ydss0857/stream-conv-engine-rtl-to-gds/asic/results/hs_w128_80mhz/metrics.csv

Metric | Value
design__lint_error__count | 0
design__lint_timing_construct__count | 0
design__lint_warning__count | 413
design__inferred_latch__count | 0
design__instance__count | 62236
design__instance__area | 561398
design__instance_unmapped__count | 0
synthesis__check_error__count | 0
design__max_slew_violation__count__corner:nom_tt_025C_1v80 | 77
design__max_fanout_violation__count__corner:nom_tt_025C_1v80 | 10
design__max_cap_violation__count__corner:nom_tt_025C_1v80 | 4
power__internal__total | 0.02661510743200779
power__switching__total | 0.009540827013552189
power__leakage__total | 0.02655705064535141
power__total | 0.06271298229694366
clock__skew__worst_hold__corner:nom_tt_025C_1v80 | -0.48575744801463805
clock__skew__worst_setup__corner:nom_tt_025C_1v80 | 0.35766704499367674
timing__hold__ws__corner:nom_tt_025C_1v80 | 0.28551906092004853
timing__setup__ws__corner:nom_tt_025C_1v80 | 4.691795529331594
timing__hold__tns__corner:nom_tt_025C_1v80 | 0.0
timing__setup__tns__corner:nom_tt_025C_1v80 | 0.0
timing__hold__wns__corner:nom_tt_025C_1v80 | 0
timing__setup__wns__corner:nom_tt_025C_1v80 | 0.0
timing__hold_vio__count__corner:nom_tt_025C_1v80 | 0
timing__hold_r2r__ws__corner:nom_tt_025C_1v80 | 0.285519
timing__hold_r2r_vio__count__corner:nom_tt_025C_1v80 | 0
timing__setup_vio__count__corner:nom_tt_025C_1v80 | 0
timing__setup_r2r__ws__corner:nom_tt_025C_1v80 | 4.691795
timing__setup_r2r_vio__count__corner:nom_tt_025C_1v80 | 0
design__max_slew_violation__count__corner:nom_ss_100C_1v60 | 2962
design__max_fanout_violation__count__corner:nom_ss_100C_1v60 | 10
design__max_cap_violation__count__corner:nom_ss_100C_1v60 | 50
clock__skew__worst_hold__corner:nom_ss_100C_1v60 | -0.6415667068086316
clock__skew__worst_setup__corner:nom_ss_100C_1v60 | 0.4199943567362062
timing__hold__ws__corner:nom_ss_100C_1v60 | 0.6066265439455707
timing__setup__ws__corner:nom_ss_100C_1v60 | -0.745168392526911
timing__hold__tns__corner:nom_ss_100C_1v60 | 0.0
timing__setup__tns__corner:nom_ss_100C_1v60 | -5.656434591930299
timing__hold__wns__corner:nom_ss_100C_1v60 | 0
timing__setup__wns__corner:nom_ss_100C_1v60 | -0.745168392526911
timing__hold_vio__count__corner:nom_ss_100C_1v60 | 0
timing__hold_r2r__ws__corner:nom_ss_100C_1v60 | 0.606627
timing__hold_r2r_vio__count__corner:nom_ss_100C_1v60 | 0
timing__setup_vio__count__corner:nom_ss_100C_1v60 | 9
timing__setup_r2r__ws__corner:nom_ss_100C_1v60 | -0.745168
timing__setup_r2r_vio__count__corner:nom_ss_100C_1v60 | 9
design__max_slew_violation__count__corner:nom_ff_n40C_1v95 | 0
design__max_fanout_violation__count__corner:nom_ff_n40C_1v95 | 10
design__max_cap_violation__count__corner:nom_ff_n40C_1v95 | 4
clock__skew__worst_hold__corner:nom_ff_n40C_1v95 | -0.4119007196354827
clock__skew__worst_setup__corner:nom_ff_n40C_1v95 | 0.32648792926635684
timing__hold__ws__corner:nom_ff_n40C_1v95 | 0.10603929146008653
timing__setup__ws__corner:nom_ff_n40C_1v95 | 6.915474166830332
timing__hold__tns__corner:nom_ff_n40C_1v95 | 0.0
timing__setup__tns__corner:nom_ff_n40C_1v95 | 0.0
timing__hold__wns__corner:nom_ff_n40C_1v95 | 0
timing__setup__wns__corner:nom_ff_n40C_1v95 | 0.0
timing__hold_vio__count__corner:nom_ff_n40C_1v95 | 0
timing__hold_r2r__ws__corner:nom_ff_n40C_1v95 | 0.106039
timing__hold_r2r_vio__count__corner:nom_ff_n40C_1v95 | 0
timing__setup_vio__count__corner:nom_ff_n40C_1v95 | 0
timing__setup_r2r__ws__corner:nom_ff_n40C_1v95 | 7.211676
timing__setup_r2r_vio__count__corner:nom_ff_n40C_1v95 | 0
design__max_slew_violation__count | 3602
design__max_fanout_violation__count | 10
design__max_cap_violation__count | 92
clock__skew__worst_hold | -0.4022102487132792
clock__skew__worst_setup | 0.31881898024013905
timing__hold__ws | 0.10480927533631709
timing__setup__ws | -1.075221719870961
timing__hold__tns | 0.0
timing__setup__tns | -9.52268069130037
timing__hold__wns | 0
timing__setup__wns | -1.075221719870961
timing__hold_vio__count | 0
timing__hold_r2r__ws | 0.104809
timing__hold_r2r_vio__count | 0
timing__setup_vio__count | 34
timing__setup_r2r__ws | -1.075222
timing__setup_r2r_vio__count | 34
design__die__bbox | 0.0 0.0 761.25 776.37
design__core__bbox | 5.76 13.32 755.04 762.57
design__io | 154
design__die__area | 591012
design__core__area | 561398
design__instance__count__stdcell | 30244
design__instance__area__stdcell | 378300
design__instance__count__macros | 0
design__instance__area__macros | 0
design__instance__count__padcells | 0
design__instance__area__padcells | 0
design__instance__count__cover | 0
design__instance__area__cover | 0
design__instance__utilization | 0.673853
design__instance__utilization__stdcell | 0.673853
design__rows | 225
design__rows:unit | 225
design__sites | 351225
design__sites:unit | 351225
design__instance__count__class:buffer | 18
design__instance__area__class:buffer | 143.856
design__instance__count__class:inverter | 141
design__instance__area__class:inverter | 676.123
design__instance__count__class:sequential_cell | 3931
design__instance__area__class:sequential_cell | 113100
design__instance__count__class:multi_input_combinational_cell | 12960
design__instance__area__class:multi_input_combinational_cell | 167191
flow__warnings__count | 1
flow__errors__count | 0
flow__warnings__count:ODB-0220 | 1
flow__warnings__type_count | 1
flow__warnings__count:ORD-0039 | 1
flow__warnings__count:STA-0122 | 43
design__instance__count__class:fill_cell | 31992
design__instance__area__class:fill_cell | 183098
design__instance__count__class:tap_cell | 6469
design__instance__area__class:tap_cell | 10340
design__power_grid_violation__count__net:VGND | 0
design__power_grid_violation__count__net:VPWR | 0
design__power_grid_violation__count | 0
floorplan__design__io | 152
design__io__hpwl | 28342615
flow__warnings__count:GRT-0281 | 1
timing__drv__floating__nets | 2
timing__drv__floating__pins | 0
design__instance__displacement__total | 38707.8
design__instance__displacement__mean | 1.264
design__instance__displacement__max | 34.68
route__wirelength__estimated | 713061
design__violations | 0
design__instance__count__class:timing_repair_buffer | 5784
design__instance__area__class:timing_repair_buffer | 73857.3
flow__warnings__count:RSZ-0020 | 1
flow__warnings__count:STA-1140 | 6
design__instance__count__class:clock_buffer | 581
design__instance__area__class:clock_buffer | 10229.8
design__instance__count__class:clock_inverter | 283
design__instance__area__class:clock_inverter | 2515.88
design__instance__count__setup_buffer | 0
design__instance__count__hold_buffer | 4091
global_route__vias | 36
global_route__wirelength | 1157011
antenna__violating__nets | 0
antenna__violating__pins | 0
route__antenna_violation__count | 0
antenna_diodes_count | 55
design__instance__count__class:antenna_cell | 77
design__instance__area__class:antenna_cell | 246.154
route__net | 23439
route__net__special | 2
route__drc_errors__iter:0 | 30
route__wirelength__iter:0 | 804485
route__drc_errors__iter:1 | 5
route__wirelength__iter:1 | 804474
route__drc_errors__iter:2 | 4
route__wirelength__iter:2 | 804474
route__drc_errors__iter:3 | 0
route__wirelength__iter:3 | 804469
route__drc_errors__iter:4 | 0
route__wirelength__iter:4 | 804434
route__drc_errors | 0
route__wirelength | 804469
route__vias | 157417
route__vias__singlecut | 157417
route__vias__multicut | 0
flow__warnings__count:DRT-0349 | 10
design__disconnected_pin__count | 22
design__critical_disconnected_pin__count | 0
route__wirelength__max | 1061.38
timing__unannotated_net__count__corner:nom_tt_025C_1v80 | 364
timing__unannotated_net_filtered__count__corner:nom_tt_025C_1v80 | 0
timing__unannotated_net__count__corner:nom_ss_100C_1v60 | 364
timing__unannotated_net_filtered__count__corner:nom_ss_100C_1v60 | 0
timing__unannotated_net__count__corner:nom_ff_n40C_1v95 | 364
timing__unannotated_net_filtered__count__corner:nom_ff_n40C_1v95 | 0
design__max_slew_violation__count__corner:min_tt_025C_1v80 | 22
design__max_fanout_violation__count__corner:min_tt_025C_1v80 | 10
design__max_cap_violation__count__corner:min_tt_025C_1v80 | 4
clock__skew__worst_hold__corner:min_tt_025C_1v80 | -0.47229776981723176
clock__skew__worst_setup__corner:min_tt_025C_1v80 | 0.34747047889138455
timing__hold__ws__corner:min_tt_025C_1v80 | 0.28394032373438177
timing__setup__ws__corner:min_tt_025C_1v80 | 4.851912786649879
timing__hold__tns__corner:min_tt_025C_1v80 | 0.0
timing__setup__tns__corner:min_tt_025C_1v80 | 0.0
timing__hold__wns__corner:min_tt_025C_1v80 | 0
timing__setup__wns__corner:min_tt_025C_1v80 | 0.0
timing__hold_vio__count__corner:min_tt_025C_1v80 | 0
timing__hold_r2r__ws__corner:min_tt_025C_1v80 | 0.283940
timing__hold_r2r_vio__count__corner:min_tt_025C_1v80 | 0
timing__setup_vio__count__corner:min_tt_025C_1v80 | 0
timing__setup_r2r__ws__corner:min_tt_025C_1v80 | 4.851913
timing__setup_r2r_vio__count__corner:min_tt_025C_1v80 | 0
timing__unannotated_net__count__corner:min_tt_025C_1v80 | 364
timing__unannotated_net_filtered__count__corner:min_tt_025C_1v80 | 0
design__max_slew_violation__count__corner:min_ss_100C_1v60 | 2428
design__max_fanout_violation__count__corner:min_ss_100C_1v60 | 10
design__max_cap_violation__count__corner:min_ss_100C_1v60 | 26
clock__skew__worst_hold__corner:min_ss_100C_1v60 | -0.6200894417898395
clock__skew__worst_setup__corner:min_ss_100C_1v60 | 0.4062113260737328
timing__hold__ws__corner:min_ss_100C_1v60 | 0.604035727422032
timing__setup__ws__corner:min_ss_100C_1v60 | -0.4419655877482001
timing__hold__tns__corner:min_ss_100C_1v60 | 0.0
timing__setup__tns__corner:min_ss_100C_1v60 | -3.0907961509454824
timing__hold__wns__corner:min_ss_100C_1v60 | 0
timing__setup__wns__corner:min_ss_100C_1v60 | -0.4419655877482001
timing__hold_vio__count__corner:min_ss_100C_1v60 | 0
timing__hold_r2r__ws__corner:min_ss_100C_1v60 | 0.604036
timing__hold_r2r_vio__count__corner:min_ss_100C_1v60 | 0
timing__setup_vio__count__corner:min_ss_100C_1v60 | 8
timing__setup_r2r__ws__corner:min_ss_100C_1v60 | -0.441966
timing__setup_r2r_vio__count__corner:min_ss_100C_1v60 | 8
timing__unannotated_net__count__corner:min_ss_100C_1v60 | 364
timing__unannotated_net_filtered__count__corner:min_ss_100C_1v60 | 0
design__max_slew_violation__count__corner:min_ff_n40C_1v95 | 0
design__max_fanout_violation__count__corner:min_ff_n40C_1v95 | 10
design__max_cap_violation__count__corner:min_ff_n40C_1v95 | 4
clock__skew__worst_hold__corner:min_ff_n40C_1v95 | -0.4022102487132792
clock__skew__worst_setup__corner:min_ff_n40C_1v95 | 0.31881898024013905
timing__hold__ws__corner:min_ff_n40C_1v95 | 0.10480927533631709
timing__setup__ws__corner:min_ff_n40C_1v95 | 6.949636618442648
timing__hold__tns__corner:min_ff_n40C_1v95 | 0.0
timing__setup__tns__corner:min_ff_n40C_1v95 | 0.0
timing__hold__wns__corner:min_ff_n40C_1v95 | 0
timing__setup__wns__corner:min_ff_n40C_1v95 | 0.0
timing__hold_vio__count__corner:min_ff_n40C_1v95 | 0
timing__hold_r2r__ws__corner:min_ff_n40C_1v95 | 0.104809
timing__hold_r2r_vio__count__corner:min_ff_n40C_1v95 | 0
timing__setup_vio__count__corner:min_ff_n40C_1v95 | 0
timing__setup_r2r__ws__corner:min_ff_n40C_1v95 | 7.313951
timing__setup_r2r_vio__count__corner:min_ff_n40C_1v95 | 0
timing__unannotated_net__count__corner:min_ff_n40C_1v95 | 364
timing__unannotated_net_filtered__count__corner:min_ff_n40C_1v95 | 0
design__max_slew_violation__count__corner:max_tt_025C_1v80 | 173
design__max_fanout_violation__count__corner:max_tt_025C_1v80 | 10
design__max_cap_violation__count__corner:max_tt_025C_1v80 | 4
clock__skew__worst_hold__corner:max_tt_025C_1v80 | -0.5042334470460795
clock__skew__worst_setup__corner:max_tt_025C_1v80 | 0.3778606701150935
timing__hold__ws__corner:max_tt_025C_1v80 | 0.2881622799718314
timing__setup__ws__corner:max_tt_025C_1v80 | 4.522387925480496
timing__hold__tns__corner:max_tt_025C_1v80 | 0.0
timing__setup__tns__corner:max_tt_025C_1v80 | 0.0
timing__hold__wns__corner:max_tt_025C_1v80 | 0
timing__setup__wns__corner:max_tt_025C_1v80 | 0.0
timing__hold_vio__count__corner:max_tt_025C_1v80 | 0
timing__hold_r2r__ws__corner:max_tt_025C_1v80 | 0.288162
timing__hold_r2r_vio__count__corner:max_tt_025C_1v80 | 0
timing__setup_vio__count__corner:max_tt_025C_1v80 | 0
timing__setup_r2r__ws__corner:max_tt_025C_1v80 | 4.522388
timing__setup_r2r_vio__count__corner:max_tt_025C_1v80 | 0
timing__unannotated_net__count__corner:max_tt_025C_1v80 | 364
timing__unannotated_net_filtered__count__corner:max_tt_025C_1v80 | 0
design__max_slew_violation__count__corner:max_ss_100C_1v60 | 3602
design__max_fanout_violation__count__corner:max_ss_100C_1v60 | 10
design__max_cap_violation__count__corner:max_ss_100C_1v60 | 92
clock__skew__worst_hold__corner:max_ss_100C_1v60 | -0.6702978362085705
clock__skew__worst_setup__corner:max_ss_100C_1v60 | 0.44692459331696793
timing__hold__ws__corner:max_ss_100C_1v60 | 0.6107459155726436
timing__setup__ws__corner:max_ss_100C_1v60 | -1.075221719870961
timing__hold__tns__corner:max_ss_100C_1v60 | 0.0
timing__setup__tns__corner:max_ss_100C_1v60 | -9.52268069130037
timing__hold__wns__corner:max_ss_100C_1v60 | 0
timing__setup__wns__corner:max_ss_100C_1v60 | -1.075221719870961
timing__hold_vio__count__corner:max_ss_100C_1v60 | 0
timing__hold_r2r__ws__corner:max_ss_100C_1v60 | 0.610746
timing__hold_r2r_vio__count__corner:max_ss_100C_1v60 | 0
timing__setup_vio__count__corner:max_ss_100C_1v60 | 17
timing__setup_r2r__ws__corner:max_ss_100C_1v60 | -1.075222
timing__setup_r2r_vio__count__corner:max_ss_100C_1v60 | 17
timing__unannotated_net__count__corner:max_ss_100C_1v60 | 364
timing__unannotated_net_filtered__count__corner:max_ss_100C_1v60 | 0
design__max_slew_violation__count__corner:max_ff_n40C_1v95 | 0
design__max_fanout_violation__count__corner:max_ff_n40C_1v95 | 10
design__max_cap_violation__count__corner:max_ff_n40C_1v95 | 4
clock__skew__worst_hold__corner:max_ff_n40C_1v95 | -0.42586338438842086
clock__skew__worst_setup__corner:max_ff_n40C_1v95 | 0.3428012415402391
timing__hold__ws__corner:max_ff_n40C_1v95 | 0.10804257794237698
timing__setup__ws__corner:max_ff_n40C_1v95 | 6.879383923903536
timing__hold__tns__corner:max_ff_n40C_1v95 | 0.0
timing__setup__tns__corner:max_ff_n40C_1v95 | 0.0
timing__hold__wns__corner:max_ff_n40C_1v95 | 0
timing__setup__wns__corner:max_ff_n40C_1v95 | 0.0
timing__hold_vio__count__corner:max_ff_n40C_1v95 | 0
timing__hold_r2r__ws__corner:max_ff_n40C_1v95 | 0.108043
timing__hold_r2r_vio__count__corner:max_ff_n40C_1v95 | 0
timing__setup_vio__count__corner:max_ff_n40C_1v95 | 0
timing__setup_r2r__ws__corner:max_ff_n40C_1v95 | 7.108401
timing__setup_r2r_vio__count__corner:max_ff_n40C_1v95 | 0
timing__unannotated_net__count__corner:max_ff_n40C_1v95 | 364
timing__unannotated_net_filtered__count__corner:max_ff_n40C_1v95 | 0
timing__unannotated_net__count | 364
timing__unannotated_net_filtered__count | 0
design_powergrid__voltage__worst__net:VPWR__corner:nom_ss_100C_1v60 | 1.79825
design_powergrid__drop__average__net:VPWR__corner:nom_ss_100C_1v60 | 1.79973
design_powergrid__drop__worst__net:VPWR__corner:nom_ss_100C_1v60 | 0.00175351
design_powergrid__voltage__worst__net:VGND__corner:nom_ss_100C_1v60 | 0.00170482
design_powergrid__drop__average__net:VGND__corner:nom_ss_100C_1v60 | 0.000268349
design_powergrid__drop__worst__net:VGND__corner:nom_ss_100C_1v60 | 0.00170482
design_powergrid__voltage__worst | 0.00170482
design_powergrid__voltage__worst__net:VPWR | 1.79825
design_powergrid__drop__worst | 0.00175351
design_powergrid__drop__worst__net:VPWR | 0.00175351
design_powergrid__voltage__worst__net:VGND | 0.00170482
design_powergrid__drop__worst__net:VGND | 0.00170482
ir__voltage__worst | 1.8000000000000000444089209850062616169452667236328125
ir__drop__avg | 0.00027300000000000002216282712907968743820674717426300048828125
ir__drop__worst | 0.00175000000000000003642919299551294898265041410923004150390625
design__xor_difference__count | 0
magic__drc_error__count | 0
klayout__drc_error__count | 0
magic__illegal_overlap__count | 0
design__lvs_device_difference__count | 0
design__lvs_net_difference__count | 0
design__lvs_property_fail__count | 0
design__lvs_error__count | 0
design__lvs_unmatched_device__count | 0
design__lvs_unmatched_net__count | 0
design__lvs_unmatched_pin__count | 0
