ydss0857/stream-conv-engine-rtl-to-gds/asic/results/w128_100mhz_v1/metrics.csv

Metric | Value
design__lint_error__count | 0
design__lint_timing_construct__count | 0
design__lint_warning__count | 468
design__inferred_latch__count | 0
design__instance__count | 106407
design__instance__area | 543198
design__instance_unmapped__count | 0
synthesis__check_error__count | 0
design__max_slew_violation__count__corner:nom_tt_025C_1v80 | 922
design__max_fanout_violation__count__corner:nom_tt_025C_1v80 | 104
design__max_cap_violation__count__corner:nom_tt_025C_1v80 | 4
power__internal__total | 0.023907823488116264
power__switching__total | 0.008693979121744633
power__leakage__total | 5.895935828448273E-7
power__total | 0.03260239213705063
clock__skew__worst_hold__corner:nom_tt_025C_1v80 | -0.5646651084316001
clock__skew__worst_setup__corner:nom_tt_025C_1v80 | 0.4305913247836536
timing__hold__ws__corner:nom_tt_025C_1v80 | 0.28795899813027337
timing__setup__ws__corner:nom_tt_025C_1v80 | 2.553215489077126
timing__hold__tns__corner:nom_tt_025C_1v80 | 0.0
timing__setup__tns__corner:nom_tt_025C_1v80 | 0.0
timing__hold__wns__corner:nom_tt_025C_1v80 | 0
timing__setup__wns__corner:nom_tt_025C_1v80 | 0.0
timing__hold_vio__count__corner:nom_tt_025C_1v80 | 0
timing__hold_r2r__ws__corner:nom_tt_025C_1v80 | 0.287959
timing__hold_r2r_vio__count__corner:nom_tt_025C_1v80 | 0
timing__setup_vio__count__corner:nom_tt_025C_1v80 | 0
timing__setup_r2r__ws__corner:nom_tt_025C_1v80 | 3.291264
timing__setup_r2r_vio__count__corner:nom_tt_025C_1v80 | 0
design__max_slew_violation__count__corner:nom_ss_100C_1v60 | 5017
design__max_fanout_violation__count__corner:nom_ss_100C_1v60 | 104
design__max_cap_violation__count__corner:nom_ss_100C_1v60 | 21
clock__skew__worst_hold__corner:nom_ss_100C_1v60 | -0.7956744377469622
clock__skew__worst_setup__corner:nom_ss_100C_1v60 | 0.5654447070615405
timing__hold__ws__corner:nom_ss_100C_1v60 | -0.28622927060898734
timing__setup__ws__corner:nom_ss_100C_1v60 | -2.5973179897546395
timing__hold__tns__corner:nom_ss_100C_1v60 | -7.600564837081983
timing__setup__tns__corner:nom_ss_100C_1v60 | -3054.2201738853555
timing__hold__wns__corner:nom_ss_100C_1v60 | -0.28622927060898734
timing__setup__wns__corner:nom_ss_100C_1v60 | -2.5973179897546395
timing__hold_vio__count__corner:nom_ss_100C_1v60 | 47
timing__hold_r2r__ws__corner:nom_ss_100C_1v60 | 0.835629
timing__hold_r2r_vio__count__corner:nom_ss_100C_1v60 | 0
timing__setup_vio__count__corner:nom_ss_100C_1v60 | 2518
timing__setup_r2r__ws__corner:nom_ss_100C_1v60 | -2.597318
timing__setup_r2r_vio__count__corner:nom_ss_100C_1v60 | 2481
design__max_slew_violation__count__corner:nom_ff_n40C_1v95 | 96
design__max_fanout_violation__count__corner:nom_ff_n40C_1v95 | 104
design__max_cap_violation__count__corner:nom_ff_n40C_1v95 | 4
clock__skew__worst_hold__corner:nom_ff_n40C_1v95 | -0.46967298046817885
clock__skew__worst_setup__corner:nom_ff_n40C_1v95 | 0.37583359710382774
timing__hold__ws__corner:nom_ff_n40C_1v95 | 0.09106782252729179
timing__setup__ws__corner:nom_ff_n40C_1v95 | 4.532833348080796
timing__hold__tns__corner:nom_ff_n40C_1v95 | 0.0
timing__setup__tns__corner:nom_ff_n40C_1v95 | 0.0
timing__hold__wns__corner:nom_ff_n40C_1v95 | 0
timing__setup__wns__corner:nom_ff_n40C_1v95 | 0.0
timing__hold_vio__count__corner:nom_ff_n40C_1v95 | 0
timing__hold_r2r__ws__corner:nom_ff_n40C_1v95 | 0.091068
timing__hold_r2r_vio__count__corner:nom_ff_n40C_1v95 | 0
timing__setup_vio__count__corner:nom_ff_n40C_1v95 | 0
timing__setup_r2r__ws__corner:nom_ff_n40C_1v95 | 5.547333
timing__setup_r2r_vio__count__corner:nom_ff_n40C_1v95 | 0
design__max_slew_violation__count | 5888
design__max_fanout_violation__count | 104
design__max_cap_violation__count | 33
clock__skew__worst_hold | -0.4553037797877009
clock__skew__worst_setup | 0.36692461219075984
timing__hold__ws | -0.4442042415183677
timing__setup__ws | -3.036861514883817
timing__hold__tns | -16.775530772663068
timing__setup__tns | -3873.726764557994
timing__hold__wns | -0.4442042415183677
timing__setup__wns | -3.036861514883817
timing__hold_vio__count | 158
timing__hold_r2r__ws | 0.091068
timing__hold_r2r_vio__count | 0
timing__setup_vio__count | 7537
timing__setup_r2r__ws | -3.036861
timing__setup_r2r_vio__count | 7428
design__die__bbox | 0.0 0.0 748.38 759.1
design__core__bbox | 5.52 10.88 742.44 748.0
design__io | 154
design__die__area | 568095
design__core__area | 543198
design__instance__count__stdcell | 31687
design__instance__area__stdcell | 290836
design__instance__count__macros | 0
design__instance__area__macros | 0
design__instance__count__padcells | 0
design__instance__area__padcells | 0
design__instance__count__cover | 0
design__instance__area__cover | 0
design__instance__utilization | 0.535415
design__instance__utilization__stdcell | 0.535415
design__rows | 271
design__rows:unithd | 271
design__sites | 434142
design__sites:unithd | 434142
design__instance__count__class:buffer | 18
design__instance__area__class:buffer | 90.0864
design__instance__count__class:inverter | 227
design__instance__area__class:inverter | 869.584
design__instance__count__class:sequential_cell | 3573
design__instance__area__class:sequential_cell | 76074.2
design__instance__count__class:multi_input_combinational_cell | 13781
design__instance__area__class:multi_input_combinational_cell | 141492
flow__warnings__count | 1
flow__errors__count | 0
flow__warnings__count:ODB-0220 | 2
flow__warnings__type_count | 1
flow__warnings__count:ORD-0039 | 1
design__instance__count__class:fill_cell | 74720
design__instance__area__class:fill_cell | 252362
design__instance__count__class:tap_cell | 7780
design__instance__area__class:tap_cell | 9734.34
design__power_grid_violation__count__net:VGND | 0
design__power_grid_violation__count__net:VPWR | 0
design__power_grid_violation__count | 0
floorplan__design__io | 152
design__io__hpwl | 29567017
flow__warnings__count:GRT-0281 | 1
timing__drv__floating__nets | 2
timing__drv__floating__pins | 0
design__instance__displacement__total | 17320.5
design__instance__displacement__mean | 0.538
design__instance__displacement__max | 30.164
route__wirelength__estimated | 682442
design__violations | 0
design__instance__count__class:timing_repair_buffer | 5621
design__instance__area__class:timing_repair_buffer | 54410.9
flow__warnings__count:RSZ-0020 | 1
flow__warnings__count:STA-1140 | 6
design__instance__count__class:clock_buffer | 543
design__instance__area__class:clock_buffer | 7297
design__instance__count__class:clock_inverter | 52
design__instance__area__class:clock_inverter | 638.112
design__instance__count__setup_buffer | 30
design__instance__count__hold_buffer | 566
flow__warnings__count:RSZ-0062 | 1
global_route__vias | 97
global_route__wirelength | 1106856
antenna__violating__nets | 0
antenna__violating__pins | 0
route__antenna_violation__count | 0
antenna_diodes_count | 42
design__instance__count__class:antenna_cell | 92
design__instance__area__class:antenna_cell | 230.221
route__net | 23746
route__net__special | 2
route__drc_errors__iter:0 | 36
route__wirelength__iter:0 | 772403
route__drc_errors__iter:1 | 5
route__wirelength__iter:1 | 772383
route__drc_errors__iter:2 | 5
route__wirelength__iter:2 | 772382
route__drc_errors__iter:3 | 0
route__wirelength__iter:3 | 772371
route__drc_errors__iter:4 | 1
route__wirelength__iter:4 | 772496
route__drc_errors__iter:5 | 0
route__wirelength__iter:5 | 772486
route__drc_errors | 0
route__wirelength | 772371
route__vias | 164251
route__vias__singlecut | 164251
route__vias__multicut | 0
flow__warnings__count:DRT-0349 | 10
design__disconnected_pin__count | 13
design__critical_disconnected_pin__count | 0
route__wirelength__max | 1125.89
timing__unannotated_net__count__corner:nom_tt_025C_1v80 | 174
timing__unannotated_net_filtered__count__corner:nom_tt_025C_1v80 | 0
timing__unannotated_net__count__corner:nom_ss_100C_1v60 | 174
timing__unannotated_net_filtered__count__corner:nom_ss_100C_1v60 | 0
timing__unannotated_net__count__corner:nom_ff_n40C_1v95 | 174
timing__unannotated_net_filtered__count__corner:nom_ff_n40C_1v95 | 0
design__max_slew_violation__count__corner:min_tt_025C_1v80 | 677
design__max_fanout_violation__count__corner:min_tt_025C_1v80 | 104
design__max_cap_violation__count__corner:min_tt_025C_1v80 | 3
clock__skew__worst_hold__corner:min_tt_025C_1v80 | -0.5451668160101715
clock__skew__worst_setup__corner:min_tt_025C_1v80 | 0.4177540376314546
timing__hold__ws__corner:min_tt_025C_1v80 | 0.2889762955165085
timing__setup__ws__corner:min_tt_025C_1v80 | 2.7826532976566853
timing__hold__tns__corner:min_tt_025C_1v80 | 0.0
timing__setup__tns__corner:min_tt_025C_1v80 | 0.0
timing__hold__wns__corner:min_tt_025C_1v80 | 0
timing__setup__wns__corner:min_tt_025C_1v80 | 0.0
timing__hold_vio__count__corner:min_tt_025C_1v80 | 0
timing__hold_r2r__ws__corner:min_tt_025C_1v80 | 0.288976
timing__hold_r2r_vio__count__corner:min_tt_025C_1v80 | 0
timing__setup_vio__count__corner:min_tt_025C_1v80 | 0
timing__setup_r2r__ws__corner:min_tt_025C_1v80 | 3.526115
timing__setup_r2r_vio__count__corner:min_tt_025C_1v80 | 0
timing__unannotated_net__count__corner:min_tt_025C_1v80 | 174
timing__unannotated_net_filtered__count__corner:min_tt_025C_1v80 | 0
design__max_slew_violation__count__corner:min_ss_100C_1v60 | 4231
design__max_fanout_violation__count__corner:min_ss_100C_1v60 | 104
design__max_cap_violation__count__corner:min_ss_100C_1v60 | 12
clock__skew__worst_hold__corner:min_ss_100C_1v60 | -0.7672802610445267
clock__skew__worst_setup__corner:min_ss_100C_1v60 | 0.5421482305431466
timing__hold__ws__corner:min_ss_100C_1v60 | -0.15243273741370653
timing__setup__ws__corner:min_ss_100C_1v60 | -2.1511690815313393
timing__hold__tns__corner:min_ss_100C_1v60 | -2.407538458959328
timing__setup__tns__corner:min_ss_100C_1v60 | -2211.094914634394
timing__hold__wns__corner:min_ss_100C_1v60 | -0.15243273741370653
timing__setup__wns__corner:min_ss_100C_1v60 | -2.1511690815313393
timing__hold_vio__count__corner:min_ss_100C_1v60 | 37
timing__hold_r2r__ws__corner:min_ss_100C_1v60 | 0.839914
timing__hold_r2r_vio__count__corner:min_ss_100C_1v60 | 0
timing__setup_vio__count__corner:min_ss_100C_1v60 | 2417
timing__setup_r2r__ws__corner:min_ss_100C_1v60 | -2.151169
timing__setup_r2r_vio__count__corner:min_ss_100C_1v60 | 2382
timing__unannotated_net__count__corner:min_ss_100C_1v60 | 174
timing__unannotated_net_filtered__count__corner:min_ss_100C_1v60 | 0
design__max_slew_violation__count__corner:min_ff_n40C_1v95 | 39
design__max_fanout_violation__count__corner:min_ff_n40C_1v95 | 104
design__max_cap_violation__count__corner:min_ff_n40C_1v95 | 3
clock__skew__worst_hold__corner:min_ff_n40C_1v95 | -0.4553037797877009
clock__skew__worst_setup__corner:min_ff_n40C_1v95 | 0.36692461219075984
timing__hold__ws__corner:min_ff_n40C_1v95 | 0.09230982906006628
timing__setup__ws__corner:min_ff_n40C_1v95 | 4.6848299898780965
timing__hold__tns__corner:min_ff_n40C_1v95 | 0.0
timing__setup__tns__corner:min_ff_n40C_1v95 | 0.0
timing__hold__wns__corner:min_ff_n40C_1v95 | 0
timing__setup__wns__corner:min_ff_n40C_1v95 | 0.0
timing__hold_vio__count__corner:min_ff_n40C_1v95 | 0
timing__hold_r2r__ws__corner:min_ff_n40C_1v95 | 0.092310
timing__hold_r2r_vio__count__corner:min_ff_n40C_1v95 | 0
timing__setup_vio__count__corner:min_ff_n40C_1v95 | 0
timing__setup_r2r__ws__corner:min_ff_n40C_1v95 | 5.698762
timing__setup_r2r_vio__count__corner:min_ff_n40C_1v95 | 0
timing__unannotated_net__count__corner:min_ff_n40C_1v95 | 174
timing__unannotated_net_filtered__count__corner:min_ff_n40C_1v95 | 0
design__max_slew_violation__count__corner:max_tt_025C_1v80 | 1096
design__max_fanout_violation__count__corner:max_tt_025C_1v80 | 104
design__max_cap_violation__count__corner:max_tt_025C_1v80 | 5
clock__skew__worst_hold__corner:max_tt_025C_1v80 | -0.5871393537547022
clock__skew__worst_setup__corner:max_tt_025C_1v80 | 0.44075064290241617
timing__hold__ws__corner:max_tt_025C_1v80 | 0.28808001244338
timing__setup__ws__corner:max_tt_025C_1v80 | 2.359544626470449
timing__hold__tns__corner:max_tt_025C_1v80 | 0.0
timing__setup__tns__corner:max_tt_025C_1v80 | 0.0
timing__hold__wns__corner:max_tt_025C_1v80 | 0
timing__setup__wns__corner:max_tt_025C_1v80 | 0.0
timing__hold_vio__count__corner:max_tt_025C_1v80 | 0
timing__hold_r2r__ws__corner:max_tt_025C_1v80 | 0.288080
timing__hold_r2r_vio__count__corner:max_tt_025C_1v80 | 0
timing__setup_vio__count__corner:max_tt_025C_1v80 | 0
timing__setup_r2r__ws__corner:max_tt_025C_1v80 | 3.044996
timing__setup_r2r_vio__count__corner:max_tt_025C_1v80 | 0
timing__unannotated_net__count__corner:max_tt_025C_1v80 | 174
timing__unannotated_net_filtered__count__corner:max_tt_025C_1v80 | 0
design__max_slew_violation__count__corner:max_ss_100C_1v60 | 5888
design__max_fanout_violation__count__corner:max_ss_100C_1v60 | 104
design__max_cap_violation__count__corner:max_ss_100C_1v60 | 33
clock__skew__worst_hold__corner:max_ss_100C_1v60 | -0.8307073042352012
clock__skew__worst_setup__corner:max_ss_100C_1v60 | 0.5816066681773102
timing__hold__ws__corner:max_ss_100C_1v60 | -0.4442042415183677
timing__setup__ws__corner:max_ss_100C_1v60 | -3.036861514883817
timing__hold__tns__corner:max_ss_100C_1v60 | -16.775530772663068
timing__setup__tns__corner:max_ss_100C_1v60 | -3873.726764557994
timing__hold__wns__corner:max_ss_100C_1v60 | -0.4442042415183677
timing__setup__wns__corner:max_ss_100C_1v60 | -3.036861514883817
timing__hold_vio__count__corner:max_ss_100C_1v60 | 74
timing__hold_r2r__ws__corner:max_ss_100C_1v60 | 0.835518
timing__hold_r2r_vio__count__corner:max_ss_100C_1v60 | 0
timing__setup_vio__count__corner:max_ss_100C_1v60 | 2602
timing__setup_r2r__ws__corner:max_ss_100C_1v60 | -3.036861
timing__setup_r2r_vio__count__corner:max_ss_100C_1v60 | 2565
timing__unannotated_net__count__corner:max_ss_100C_1v60 | 174
timing__unannotated_net_filtered__count__corner:max_ss_100C_1v60 | 0
design__max_slew_violation__count__corner:max_ff_n40C_1v95 | 260
design__max_fanout_violation__count__corner:max_ff_n40C_1v95 | 104
design__max_cap_violation__count__corner:max_ff_n40C_1v95 | 5
clock__skew__worst_hold__corner:max_ff_n40C_1v95 | -0.48683314313362014
clock__skew__worst_setup__corner:max_ff_n40C_1v95 | 0.3828969194529842
timing__hold__ws__corner:max_ff_n40C_1v95 | 0.09149226080160991
timing__setup__ws__corner:max_ff_n40C_1v95 | 4.3988804954792275
timing__hold__tns__corner:max_ff_n40C_1v95 | 0.0
timing__setup__tns__corner:max_ff_n40C_1v95 | 0.0
timing__hold__wns__corner:max_ff_n40C_1v95 | 0
timing__setup__wns__corner:max_ff_n40C_1v95 | 0.0
timing__hold_vio__count__corner:max_ff_n40C_1v95 | 0
timing__hold_r2r__ws__corner:max_ff_n40C_1v95 | 0.091492
timing__hold_r2r_vio__count__corner:max_ff_n40C_1v95 | 0
timing__setup_vio__count__corner:max_ff_n40C_1v95 | 0
timing__setup_r2r__ws__corner:max_ff_n40C_1v95 | 5.390066
timing__setup_r2r_vio__count__corner:max_ff_n40C_1v95 | 0
timing__unannotated_net__count__corner:max_ff_n40C_1v95 | 174
timing__unannotated_net_filtered__count__corner:max_ff_n40C_1v95 | 0
timing__unannotated_net__count | 174
timing__unannotated_net_filtered__count | 0
design_powergrid__voltage__worst__net:VPWR__corner:nom_tt_025C_1v80 | 1.79899
design_powergrid__drop__average__net:VPWR__corner:nom_tt_025C_1v80 | 1.79987
design_powergrid__drop__worst__net:VPWR__corner:nom_tt_025C_1v80 | 0.00101176
design_powergrid__voltage__worst__net:VGND__corner:nom_tt_025C_1v80 | 0.0010429
design_powergrid__drop__average__net:VGND__corner:nom_tt_025C_1v80 | 0.00013005
design_powergrid__drop__worst__net:VGND__corner:nom_tt_025C_1v80 | 0.0010429
design_powergrid__voltage__worst | 0.0010429
design_powergrid__voltage__worst__net:VPWR | 1.79899
design_powergrid__drop__worst | 0.0010429
design_powergrid__drop__worst__net:VPWR | 0.00101176
design_powergrid__voltage__worst__net:VGND | 0.0010429
design_powergrid__drop__worst__net:VGND | 0.0010429
ir__voltage__worst | 1.8000000000000000444089209850062616169452667236328125
ir__drop__avg | 0.0001320000000000000101203767588486925887991674244403839111328125
ir__drop__worst | 0.0010100000000000000470457006684910084004513919353485107421875
design__xor_difference__count | 0
magic__drc_error__count | 0
klayout__drc_error__count | 0
magic__illegal_overlap__count | 0
design__lvs_device_difference__count | 0
design__lvs_net_difference__count | 0
design__lvs_property_fail__count | 0
design__lvs_error__count | 0
design__lvs_unmatched_device__count | 0
design__lvs_unmatched_net__count | 0
design__lvs_unmatched_pin__count | 0
