ydss0857/stream-conv-engine-rtl-to-gds/asic/results/w128_100mhz_v2/metrics.csv

Metric | Value
design__lint_error__count | 0
design__lint_timing_construct__count | 0
design__lint_warning__count | 468
design__inferred_latch__count | 0
design__instance__count | 108684
design__instance__area | 559474
design__instance_unmapped__count | 0
synthesis__check_error__count | 0
design__max_slew_violation__count__corner:nom_tt_025C_1v80 | 699
design__max_fanout_violation__count__corner:nom_tt_025C_1v80 | 111
design__max_cap_violation__count__corner:nom_tt_025C_1v80 | 4
power__internal__total | 0.025229910388588905
power__switching__total | 0.009079274721443653
power__leakage__total | 6.083745347496006E-7
power__total | 0.03430979326367378
clock__skew__worst_hold__corner:nom_tt_025C_1v80 | -0.5956840744830885
clock__skew__worst_setup__corner:nom_tt_025C_1v80 | 0.45397772936958536
timing__hold__ws__corner:nom_tt_025C_1v80 | 0.284867137941551
timing__setup__ws__corner:nom_tt_025C_1v80 | 2.7879317421542478
timing__hold__tns__corner:nom_tt_025C_1v80 | 0.0
timing__setup__tns__corner:nom_tt_025C_1v80 | 0.0
timing__hold__wns__corner:nom_tt_025C_1v80 | 0
timing__setup__wns__corner:nom_tt_025C_1v80 | 0.0
timing__hold_vio__count__corner:nom_tt_025C_1v80 | 0
timing__hold_r2r__ws__corner:nom_tt_025C_1v80 | 0.284867
timing__hold_r2r_vio__count__corner:nom_tt_025C_1v80 | 0
timing__setup_vio__count__corner:nom_tt_025C_1v80 | 0
timing__setup_r2r__ws__corner:nom_tt_025C_1v80 | 3.434569
timing__setup_r2r_vio__count__corner:nom_tt_025C_1v80 | 0
design__max_slew_violation__count__corner:nom_ss_100C_1v60 | 5296
design__max_fanout_violation__count__corner:nom_ss_100C_1v60 | 111
design__max_cap_violation__count__corner:nom_ss_100C_1v60 | 24
clock__skew__worst_hold__corner:nom_ss_100C_1v60 | -0.8548888505738577
clock__skew__worst_setup__corner:nom_ss_100C_1v60 | 0.6077816200130585
timing__hold__ws__corner:nom_ss_100C_1v60 | -0.39988591347876296
timing__setup__ws__corner:nom_ss_100C_1v60 | -2.3116522683688903
timing__hold__tns__corner:nom_ss_100C_1v60 | -14.898567246043969
timing__setup__tns__corner:nom_ss_100C_1v60 | -1467.3654919803594
timing__hold__wns__corner:nom_ss_100C_1v60 | -0.39988591347876296
timing__setup__wns__corner:nom_ss_100C_1v60 | -2.3116522683688903
timing__hold_vio__count__corner:nom_ss_100C_1v60 | 69
timing__hold_r2r__ws__corner:nom_ss_100C_1v60 | 0.847256
timing__hold_r2r_vio__count__corner:nom_ss_100C_1v60 | 0
timing__setup_vio__count__corner:nom_ss_100C_1v60 | 1904
timing__setup_r2r__ws__corner:nom_ss_100C_1v60 | -2.311652
timing__setup_r2r_vio__count__corner:nom_ss_100C_1v60 | 1885
design__max_slew_violation__count__corner:nom_ff_n40C_1v95 | 90
design__max_fanout_violation__count__corner:nom_ff_n40C_1v95 | 111
design__max_cap_violation__count__corner:nom_ff_n40C_1v95 | 4
clock__skew__worst_hold__corner:nom_ff_n40C_1v95 | -0.4904019551472106
clock__skew__worst_setup__corner:nom_ff_n40C_1v95 | 0.3929024716784874
timing__hold__ws__corner:nom_ff_n40C_1v95 | 0.08464884588427546
timing__setup__ws__corner:nom_ff_n40C_1v95 | 4.694130550463024
timing__hold__tns__corner:nom_ff_n40C_1v95 | 0.0
timing__setup__tns__corner:nom_ff_n40C_1v95 | 0.0
timing__hold__wns__corner:nom_ff_n40C_1v95 | 0
timing__setup__wns__corner:nom_ff_n40C_1v95 | 0.0
timing__hold_vio__count__corner:nom_ff_n40C_1v95 | 0
timing__hold_r2r__ws__corner:nom_ff_n40C_1v95 | 0.084649
timing__hold_r2r_vio__count__corner:nom_ff_n40C_1v95 | 0
timing__setup_vio__count__corner:nom_ff_n40C_1v95 | 0
timing__setup_r2r__ws__corner:nom_ff_n40C_1v95 | 5.588329
timing__setup_r2r_vio__count__corner:nom_ff_n40C_1v95 | 0
design__max_slew_violation__count | 6197
design__max_fanout_violation__count | 111
design__max_cap_violation__count | 31
clock__skew__worst_hold | -0.47284388853849013
clock__skew__worst_setup | 0.379640246651595
timing__hold__ws | -0.5379850051053607
timing__setup__ws | -2.693303434286286
timing__hold__tns | -24.46170268914898
timing__setup__tns | -2069.4463404217004
timing__hold__wns | -0.5379850051053607
timing__setup__wns | -2.693303434286286
timing__hold_vio__count | 182
timing__hold_r2r__ws | 0.084649
timing__hold_r2r_vio__count | 0
timing__setup_vio__count | 5861
timing__setup_r2r__ws | -2.693303
timing__setup_r2r_vio__count | 5810
design__die__bbox | 0.0 0.0 759.22 769.94
design__core__bbox | 5.52 10.88 753.48 758.88
design__io | 154
design__die__area | 584554
design__core__area | 559474
design__instance__count__stdcell | 32553
design__instance__area__stdcell | 302030
design__instance__count__macros | 0
design__instance__area__macros | 0
design__instance__count__padcells | 0
design__instance__area__padcells | 0
design__instance__count__cover | 0
design__instance__area__cover | 0
design__instance__utilization | 0.539846
design__instance__utilization__stdcell | 0.539846
design__rows | 275
design__rows:unithd | 275
design__sites | 447150
design__sites:unithd | 447150
design__instance__count__class:buffer | 18
design__instance__area__class:buffer | 90.0864
design__instance__count__class:inverter | 197
design__instance__area__class:inverter | 739.459
design__instance__count__class:sequential_cell | 3745
design__instance__area__class:sequential_cell | 79732.7
design__instance__count__class:multi_input_combinational_cell | 13942
design__instance__area__class:multi_input_combinational_cell | 144763
flow__warnings__count | 1
flow__errors__count | 0
flow__warnings__count:ODB-0220 | 2
flow__warnings__type_count | 1
flow__warnings__count:ORD-0039 | 1
design__instance__count__class:fill_cell | 76131
design__instance__area__class:fill_cell | 257444
design__instance__count__class:tap_cell | 7894
design__instance__area__class:tap_cell | 9876.97
design__power_grid_violation__count__net:VGND | 0
design__power_grid_violation__count__net:VPWR | 0
design__power_grid_violation__count | 0
floorplan__design__io | 152
design__io__hpwl | 30489223
flow__warnings__count:GRT-0281 | 1
timing__drv__floating__nets | 2
timing__drv__floating__pins | 0
design__instance__displacement__total | 18360.1
design__instance__displacement__mean | 0.556
design__instance__displacement__max | 18.36
route__wirelength__estimated | 692306
design__violations | 0
design__instance__count__class:timing_repair_buffer | 5984
design__instance__area__class:timing_repair_buffer | 57849.2
flow__warnings__count:RSZ-0020 | 1
flow__warnings__count:STA-1140 | 6
design__instance__count__class:clock_buffer | 612
design__instance__area__class:clock_buffer | 8184.1
design__instance__count__class:clock_inverter | 63
design__instance__area__class:clock_inverter | 549.277
design__instance__count__setup_buffer | 82
design__instance__count__hold_buffer | 32
flow__warnings__count:RSZ-0064 | 1
global_route__vias | 870
global_route__wirelength | 1123637
antenna__violating__nets | 0
antenna__violating__pins | 0
route__antenna_violation__count | 0
antenna_diodes_count | 43
design__instance__count__class:antenna_cell | 98
design__instance__area__class:antenna_cell | 245.235
route__net | 24428
route__net__special | 2
route__drc_errors__iter:0 | 606
route__wirelength__iter:0 | 782506
route__drc_errors__iter:1 | 65
route__wirelength__iter:1 | 782353
route__drc_errors__iter:2 | 37
route__wirelength__iter:2 | 782361
route__drc_errors__iter:3 | 0
route__wirelength__iter:3 | 782283
route__drc_errors__iter:4 | 0
route__wirelength__iter:4 | 782185
route__drc_errors | 0
route__wirelength | 782283
route__vias | 169099
route__vias__singlecut | 169099
route__vias__multicut | 0
flow__warnings__count:DRT-0349 | 10
flow__warnings__count:GRT-0243 | 1
design__disconnected_pin__count | 13
design__critical_disconnected_pin__count | 0
route__wirelength__max | 1123.49
timing__unannotated_net__count__corner:nom_tt_025C_1v80 | 238
timing__unannotated_net_filtered__count__corner:nom_tt_025C_1v80 | 0
timing__unannotated_net__count__corner:nom_ss_100C_1v60 | 238
timing__unannotated_net_filtered__count__corner:nom_ss_100C_1v60 | 0
timing__unannotated_net__count__corner:nom_ff_n40C_1v95 | 238
timing__unannotated_net_filtered__count__corner:nom_ff_n40C_1v95 | 0
design__max_slew_violation__count__corner:min_tt_025C_1v80 | 447
design__max_fanout_violation__count__corner:min_tt_025C_1v80 | 111
design__max_cap_violation__count__corner:min_tt_025C_1v80 | 3
clock__skew__worst_hold__corner:min_tt_025C_1v80 | -0.5689694432198067
clock__skew__worst_setup__corner:min_tt_025C_1v80 | 0.43388135978787634
timing__hold__ws__corner:min_tt_025C_1v80 | 0.28955472172869723
timing__setup__ws__corner:min_tt_025C_1v80 | 3.024802716138502
timing__hold__tns__corner:min_tt_025C_1v80 | 0.0
timing__setup__tns__corner:min_tt_025C_1v80 | 0.0
timing__hold__wns__corner:min_tt_025C_1v80 | 0
timing__setup__wns__corner:min_tt_025C_1v80 | 0.0
timing__hold_vio__count__corner:min_tt_025C_1v80 | 0
timing__hold_r2r__ws__corner:min_tt_025C_1v80 | 0.289555
timing__hold_r2r_vio__count__corner:min_tt_025C_1v80 | 0
timing__setup_vio__count__corner:min_tt_025C_1v80 | 0
timing__setup_r2r__ws__corner:min_tt_025C_1v80 | 3.663878
timing__setup_r2r_vio__count__corner:min_tt_025C_1v80 | 0
timing__unannotated_net__count__corner:min_tt_025C_1v80 | 238
timing__unannotated_net_filtered__count__corner:min_tt_025C_1v80 | 0
design__max_slew_violation__count__corner:min_ss_100C_1v60 | 4391
design__max_fanout_violation__count__corner:min_ss_100C_1v60 | 111
design__max_cap_violation__count__corner:min_ss_100C_1v60 | 12
clock__skew__worst_hold__corner:min_ss_100C_1v60 | -0.8108333123316138
clock__skew__worst_setup__corner:min_ss_100C_1v60 | 0.5755825978753217
timing__hold__ws__corner:min_ss_100C_1v60 | -0.2602989009124812
timing__setup__ws__corner:min_ss_100C_1v60 | -1.852940964222063
timing__hold__tns__corner:min_ss_100C_1v60 | -7.508980316744418
timing__setup__tns__corner:min_ss_100C_1v60 | -948.4095057742146
timing__hold__wns__corner:min_ss_100C_1v60 | -0.2602989009124812
timing__setup__wns__corner:min_ss_100C_1v60 | -1.852940964222063
timing__hold_vio__count__corner:min_ss_100C_1v60 | 43
timing__hold_r2r__ws__corner:min_ss_100C_1v60 | 0.840262
timing__hold_r2r_vio__count__corner:min_ss_100C_1v60 | 0
timing__setup_vio__count__corner:min_ss_100C_1v60 | 1578
timing__setup_r2r__ws__corner:min_ss_100C_1v60 | -1.852941
timing__setup_r2r_vio__count__corner:min_ss_100C_1v60 | 1565
timing__unannotated_net__count__corner:min_ss_100C_1v60 | 238
timing__unannotated_net_filtered__count__corner:min_ss_100C_1v60 | 0
design__max_slew_violation__count__corner:min_ff_n40C_1v95 | 52
design__max_fanout_violation__count__corner:min_ff_n40C_1v95 | 111
design__max_cap_violation__count__corner:min_ff_n40C_1v95 | 3
clock__skew__worst_hold__corner:min_ff_n40C_1v95 | -0.47284388853849013
clock__skew__worst_setup__corner:min_ff_n40C_1v95 | 0.379640246651595
timing__hold__ws__corner:min_ff_n40C_1v95 | 0.08677692143806304
timing__setup__ws__corner:min_ff_n40C_1v95 | 4.851301719879843
timing__hold__tns__corner:min_ff_n40C_1v95 | 0.0
timing__setup__tns__corner:min_ff_n40C_1v95 | 0.0
timing__hold__wns__corner:min_ff_n40C_1v95 | 0
timing__setup__wns__corner:min_ff_n40C_1v95 | 0.0
timing__hold_vio__count__corner:min_ff_n40C_1v95 | 0
timing__hold_r2r__ws__corner:min_ff_n40C_1v95 | 0.086777
timing__hold_r2r_vio__count__corner:min_ff_n40C_1v95 | 0
timing__setup_vio__count__corner:min_ff_n40C_1v95 | 0
timing__setup_r2r__ws__corner:min_ff_n40C_1v95 | 5.740241
timing__setup_r2r_vio__count__corner:min_ff_n40C_1v95 | 0
timing__unannotated_net__count__corner:min_ff_n40C_1v95 | 238
timing__unannotated_net_filtered__count__corner:min_ff_n40C_1v95 | 0
design__max_slew_violation__count__corner:max_tt_025C_1v80 | 988
design__max_fanout_violation__count__corner:max_tt_025C_1v80 | 111
design__max_cap_violation__count__corner:max_tt_025C_1v80 | 4
clock__skew__worst_hold__corner:max_tt_025C_1v80 | -0.6191271004448775
clock__skew__worst_setup__corner:max_tt_025C_1v80 | 0.47203786659981645
timing__hold__ws__corner:max_tt_025C_1v80 | 0.2849758287787358
timing__setup__ws__corner:max_tt_025C_1v80 | 2.5617064750096006
timing__hold__tns__corner:max_tt_025C_1v80 | 0.0
timing__setup__tns__corner:max_tt_025C_1v80 | 0.0
timing__hold__wns__corner:max_tt_025C_1v80 | 0
timing__setup__wns__corner:max_tt_025C_1v80 | 0.0
timing__hold_vio__count__corner:max_tt_025C_1v80 | 0
timing__hold_r2r__ws__corner:max_tt_025C_1v80 | 0.284976
timing__hold_r2r_vio__count__corner:max_tt_025C_1v80 | 0
timing__setup_vio__count__corner:max_tt_025C_1v80 | 0
timing__setup_r2r__ws__corner:max_tt_025C_1v80 | 3.218901
timing__setup_r2r_vio__count__corner:max_tt_025C_1v80 | 0
timing__unannotated_net__count__corner:max_tt_025C_1v80 | 238
timing__unannotated_net_filtered__count__corner:max_tt_025C_1v80 | 0
design__max_slew_violation__count__corner:max_ss_100C_1v60 | 6197
design__max_fanout_violation__count__corner:max_ss_100C_1v60 | 111
design__max_cap_violation__count__corner:max_ss_100C_1v60 | 31
clock__skew__worst_hold__corner:max_ss_100C_1v60 | -0.885499809652257
clock__skew__worst_setup__corner:max_ss_100C_1v60 | 0.6279840158966178
timing__hold__ws__corner:max_ss_100C_1v60 | -0.5379850051053607
timing__setup__ws__corner:max_ss_100C_1v60 | -2.693303434286286
timing__hold__tns__corner:max_ss_100C_1v60 | -24.46170268914898
timing__setup__tns__corner:max_ss_100C_1v60 | -2069.4463404217004
timing__hold__wns__corner:max_ss_100C_1v60 | -0.5379850051053607
timing__setup__wns__corner:max_ss_100C_1v60 | -2.693303434286286
timing__hold_vio__count__corner:max_ss_100C_1v60 | 70
timing__hold_r2r__ws__corner:max_ss_100C_1v60 | 0.855799
timing__hold_r2r_vio__count__corner:max_ss_100C_1v60 | 0
timing__setup_vio__count__corner:max_ss_100C_1v60 | 2379
timing__setup_r2r__ws__corner:max_ss_100C_1v60 | -2.693303
timing__setup_r2r_vio__count__corner:max_ss_100C_1v60 | 2360
timing__unannotated_net__count__corner:max_ss_100C_1v60 | 238
timing__unannotated_net_filtered__count__corner:max_ss_100C_1v60 | 0
design__max_slew_violation__count__corner:max_ff_n40C_1v95 | 185
design__max_fanout_violation__count__corner:max_ff_n40C_1v95 | 111
design__max_cap_violation__count__corner:max_ff_n40C_1v95 | 4
clock__skew__worst_hold__corner:max_ff_n40C_1v95 | -0.5063488660570283
clock__skew__worst_setup__corner:max_ff_n40C_1v95 | 0.4053593964116925
timing__hold__ws__corner:max_ff_n40C_1v95 | 0.08564782459008621
timing__setup__ws__corner:max_ff_n40C_1v95 | 4.543952898120715
timing__hold__tns__corner:max_ff_n40C_1v95 | 0.0
timing__setup__tns__corner:max_ff_n40C_1v95 | 0.0
timing__hold__wns__corner:max_ff_n40C_1v95 | 0
timing__setup__wns__corner:max_ff_n40C_1v95 | 0.0
timing__hold_vio__count__corner:max_ff_n40C_1v95 | 0
timing__hold_r2r__ws__corner:max_ff_n40C_1v95 | 0.085648
timing__hold_r2r_vio__count__corner:max_ff_n40C_1v95 | 0
timing__setup_vio__count__corner:max_ff_n40C_1v95 | 0
timing__setup_r2r__ws__corner:max_ff_n40C_1v95 | 5.442912
timing__setup_r2r_vio__count__corner:max_ff_n40C_1v95 | 0
timing__unannotated_net__count__corner:max_ff_n40C_1v95 | 238
timing__unannotated_net_filtered__count__corner:max_ff_n40C_1v95 | 0
timing__unannotated_net__count | 238
timing__unannotated_net_filtered__count | 0
design_powergrid__voltage__worst__net:VPWR__corner:nom_tt_025C_1v80 | 1.79886
design_powergrid__drop__average__net:VPWR__corner:nom_tt_025C_1v80 | 1.79986
design_powergrid__drop__worst__net:VPWR__corner:nom_tt_025C_1v80 | 0.00113629
design_powergrid__voltage__worst__net:VGND__corner:nom_tt_025C_1v80 | 0.000894163
design_powergrid__drop__average__net:VGND__corner:nom_tt_025C_1v80 | 0.00013767
design_powergrid__drop__worst__net:VGND__corner:nom_tt_025C_1v80 | 0.000894163
design_powergrid__voltage__worst | 0.000894163
design_powergrid__voltage__worst__net:VPWR | 1.79886
design_powergrid__drop__worst | 0.00113629
design_powergrid__drop__worst__net:VPWR | 0.00113629
design_powergrid__voltage__worst__net:VGND | 0.000894163
design_powergrid__drop__worst__net:VGND | 0.000894163
ir__voltage__worst | 1.8000000000000000444089209850062616169452667236328125
ir__drop__avg | 0.00013899999999999999053361399159456368579412810504436492919921875
ir__drop__worst | 0.0011399999999999999543420781122904372750781476497650146484375
design__xor_difference__count | 0
magic__drc_error__count | 0
klayout__drc_error__count | 0
magic__illegal_overlap__count | 0
design__lvs_device_difference__count | 0
design__lvs_net_difference__count | 0
design__lvs_property_fail__count | 0
design__lvs_error__count | 0
design__lvs_unmatched_device__count | 0
design__lvs_unmatched_net__count | 0
design__lvs_unmatched_pin__count | 0
