ydss0857/stream-conv-engine-rtl-to-gds/asic/results/w128_100mhz_v3/metrics.csv

Metric | Value
design__lint_error__count | 0
design__lint_timing_construct__count | 0
design__lint_warning__count | 468
design__inferred_latch__count | 0
design__instance__count | 111243
design__instance__area | 559474
design__instance_unmapped__count | 0
synthesis__check_error__count | 0
design__max_slew_violation__count__corner:nom_tt_025C_1v80 | 1497
design__max_fanout_violation__count__corner:nom_tt_025C_1v80 | 102
design__max_cap_violation__count__corner:nom_tt_025C_1v80 | 4
power__internal__total | 0.025229893624782562
power__switching__total | 0.009089061059057713
power__leakage__total | 6.092042781347118E-7
power__total | 0.03431956470012665
clock__skew__worst_hold__corner:nom_tt_025C_1v80 | -0.5801462807694157
clock__skew__worst_setup__corner:nom_tt_025C_1v80 | 0.4366263307827439
timing__hold__ws__corner:nom_tt_025C_1v80 | 0.30386427567549024
timing__setup__ws__corner:nom_tt_025C_1v80 | 3.295259269835162
timing__hold__tns__corner:nom_tt_025C_1v80 | 0.0
timing__setup__tns__corner:nom_tt_025C_1v80 | 0.0
timing__hold__wns__corner:nom_tt_025C_1v80 | 0
timing__setup__wns__corner:nom_tt_025C_1v80 | 0.0
timing__hold_vio__count__corner:nom_tt_025C_1v80 | 0
timing__hold_r2r__ws__corner:nom_tt_025C_1v80 | 0.303864
timing__hold_r2r_vio__count__corner:nom_tt_025C_1v80 | 0
timing__setup_vio__count__corner:nom_tt_025C_1v80 | 0
timing__setup_r2r__ws__corner:nom_tt_025C_1v80 | 3.295259
timing__setup_r2r_vio__count__corner:nom_tt_025C_1v80 | 0
design__max_slew_violation__count__corner:nom_ss_100C_1v60 | 5670
design__max_fanout_violation__count__corner:nom_ss_100C_1v60 | 102
design__max_cap_violation__count__corner:nom_ss_100C_1v60 | 41
clock__skew__worst_hold__corner:nom_ss_100C_1v60 | -0.8323558744510918
clock__skew__worst_setup__corner:nom_ss_100C_1v60 | 0.5860269102525657
timing__hold__ws__corner:nom_ss_100C_1v60 | -0.5140317206270228
timing__setup__ws__corner:nom_ss_100C_1v60 | -2.6727572023222756
timing__hold__tns__corner:nom_ss_100C_1v60 | -7.092444166049845
timing__setup__tns__corner:nom_ss_100C_1v60 | -450.92367738294666
timing__hold__wns__corner:nom_ss_100C_1v60 | -0.5140317206270228
timing__setup__wns__corner:nom_ss_100C_1v60 | -2.6727572023222756
timing__hold_vio__count__corner:nom_ss_100C_1v60 | 21
timing__hold_r2r__ws__corner:nom_ss_100C_1v60 | 0.849532
timing__hold_r2r_vio__count__corner:nom_ss_100C_1v60 | 0
timing__setup_vio__count__corner:nom_ss_100C_1v60 | 773
timing__setup_r2r__ws__corner:nom_ss_100C_1v60 | -2.672757
timing__setup_r2r_vio__count__corner:nom_ss_100C_1v60 | 772
design__max_slew_violation__count__corner:nom_ff_n40C_1v95 | 239
design__max_fanout_violation__count__corner:nom_ff_n40C_1v95 | 102
design__max_cap_violation__count__corner:nom_ff_n40C_1v95 | 4
clock__skew__worst_hold__corner:nom_ff_n40C_1v95 | -0.47840655013839484
clock__skew__worst_setup__corner:nom_ff_n40C_1v95 | 0.378931063918983
timing__hold__ws__corner:nom_ff_n40C_1v95 | 0.10829515368762253
timing__setup__ws__corner:nom_ff_n40C_1v95 | 5.31275882768883
timing__hold__tns__corner:nom_ff_n40C_1v95 | 0.0
timing__setup__tns__corner:nom_ff_n40C_1v95 | 0.0
timing__hold__wns__corner:nom_ff_n40C_1v95 | 0
timing__setup__wns__corner:nom_ff_n40C_1v95 | 0.0
timing__hold_vio__count__corner:nom_ff_n40C_1v95 | 0
timing__hold_r2r__ws__corner:nom_ff_n40C_1v95 | 0.108295
timing__hold_r2r_vio__count__corner:nom_ff_n40C_1v95 | 0
timing__setup_vio__count__corner:nom_ff_n40C_1v95 | 0
timing__setup_r2r__ws__corner:nom_ff_n40C_1v95 | 5.589057
timing__setup_r2r_vio__count__corner:nom_ff_n40C_1v95 | 0
design__max_slew_violation__count | 6251
design__max_fanout_violation__count | 102
design__max_cap_violation__count | 58
clock__skew__worst_hold | -0.46435587245269033
clock__skew__worst_setup | 0.37001783240272584
timing__hold__ws | -0.6459903905753609
timing__setup__ws | -3.124993685606369
timing__hold__tns | -9.896907573597518
timing__setup__tns | -741.7118222879277
timing__hold__wns | -0.6459903905753609
timing__setup__wns | -3.124993685606369
timing__hold_vio__count | 62
timing__hold_r2r__ws | 0.105983
timing__hold_r2r_vio__count | 0
timing__setup_vio__count | 2293
timing__setup_r2r__ws | -3.124994
timing__setup_r2r_vio__count | 2290
design__die__bbox | 0.0 0.0 759.22 769.94
design__core__bbox | 5.52 10.88 753.48 758.88
design__io | 154
design__die__area | 584554
design__core__area | 559474
design__instance__count__stdcell | 32857
design__instance__area__stdcell | 293779
design__instance__count__macros | 0
design__instance__area__macros | 0
design__instance__count__padcells | 0
design__instance__area__padcells | 0
design__instance__count__cover | 0
design__instance__area__cover | 0
design__instance__utilization | 0.525099
design__instance__utilization__stdcell | 0.525099
design__rows | 275
design__rows:unithd | 275
design__sites | 447150
design__sites:unithd | 447150
design__instance__count__class:buffer | 18
design__instance__area__class:buffer | 90.0864
design__instance__count__class:inverter | 197
design__instance__area__class:inverter | 739.459
design__instance__count__class:sequential_cell | 3745
design__instance__area__class:sequential_cell | 79730.2
design__instance__count__class:multi_input_combinational_cell | 13942
design__instance__area__class:multi_input_combinational_cell | 144555
flow__warnings__count | 1
flow__errors__count | 0
flow__warnings__count:ODB-0220 | 2
flow__warnings__type_count | 1
flow__warnings__count:ORD-0039 | 1
design__instance__count__class:fill_cell | 78386
design__instance__area__class:fill_cell | 265695
design__instance__count__class:tap_cell | 7894
design__instance__area__class:tap_cell | 9876.97
design__power_grid_violation__count__net:VGND | 0
design__power_grid_violation__count__net:VPWR | 0
design__power_grid_violation__count | 0
floorplan__design__io | 152
design__io__hpwl | 30489223
flow__warnings__count:GRT-0281 | 1
timing__drv__floating__nets | 2
timing__drv__floating__pins | 0
design__instance__displacement__total | 17270.7
design__instance__displacement__mean | 0.518
design__instance__displacement__max | 23.308
route__wirelength__estimated | 695059
design__violations | 0
design__instance__count__class:timing_repair_buffer | 6285
design__instance__area__class:timing_repair_buffer | 49790.3
flow__warnings__count:RSZ-0020 | 1
flow__warnings__count:STA-1140 | 6
design__instance__count__class:clock_buffer | 613
design__instance__area__class:clock_buffer | 8197.86
design__instance__count__class:clock_inverter | 63
design__instance__area__class:clock_inverter | 549.277
design__instance__count__setup_buffer | 65
design__instance__count__hold_buffer | 314
flow__warnings__count:RSZ-0062 | 1
global_route__vias | 17
global_route__wirelength | 1119559
antenna__violating__nets | 1
antenna__violating__pins | 1
route__antenna_violation__count | 1
antenna_diodes_count | 55
design__instance__count__class:antenna_cell | 100
design__instance__area__class:antenna_cell | 250.24
route__net | 24729
route__net__special | 2
route__drc_errors__iter:0 | 2
route__wirelength__iter:0 | 777868
route__drc_errors__iter:1 | 0
route__wirelength__iter:1 | 777865
route__drc_errors__iter:2 | 1
route__wirelength__iter:2 | 777860
route__drc_errors__iter:3 | 0
route__wirelength__iter:3 | 777860
route__drc_errors__iter:4 | 0
route__wirelength__iter:4 | 777717
route__drc_errors | 0
route__wirelength | 777865
route__vias | 169437
route__vias__singlecut | 169437
route__vias__multicut | 0
flow__warnings__count:DRT-0349 | 10
design__disconnected_pin__count | 13
design__critical_disconnected_pin__count | 0
route__wirelength__max | 1122.83
timing__unannotated_net__count__corner:nom_tt_025C_1v80 | 239
timing__unannotated_net_filtered__count__corner:nom_tt_025C_1v80 | 0
timing__unannotated_net__count__corner:nom_ss_100C_1v60 | 239
timing__unannotated_net_filtered__count__corner:nom_ss_100C_1v60 | 0
timing__unannotated_net__count__corner:nom_ff_n40C_1v95 | 239
timing__unannotated_net_filtered__count__corner:nom_ff_n40C_1v95 | 0
design__max_slew_violation__count__corner:min_tt_025C_1v80 | 1160
design__max_fanout_violation__count__corner:min_tt_025C_1v80 | 102
design__max_cap_violation__count__corner:min_tt_025C_1v80 | 3
clock__skew__worst_hold__corner:min_tt_025C_1v80 | -0.5578115904844558
clock__skew__worst_setup__corner:min_tt_025C_1v80 | 0.42182322717639525
timing__hold__ws__corner:min_tt_025C_1v80 | 0.3058496875665787
timing__setup__ws__corner:min_tt_025C_1v80 | 3.5967443375015917
timing__hold__tns__corner:min_tt_025C_1v80 | 0.0
timing__setup__tns__corner:min_tt_025C_1v80 | 0.0
timing__hold__wns__corner:min_tt_025C_1v80 | 0
timing__setup__wns__corner:min_tt_025C_1v80 | 0.0
timing__hold_vio__count__corner:min_tt_025C_1v80 | 0
timing__hold_r2r__ws__corner:min_tt_025C_1v80 | 0.305850
timing__hold_r2r_vio__count__corner:min_tt_025C_1v80 | 0
timing__setup_vio__count__corner:min_tt_025C_1v80 | 0
timing__setup_r2r__ws__corner:min_tt_025C_1v80 | 3.596744
timing__setup_r2r_vio__count__corner:min_tt_025C_1v80 | 0
timing__unannotated_net__count__corner:min_tt_025C_1v80 | 239
timing__unannotated_net_filtered__count__corner:min_tt_025C_1v80 | 0
design__max_slew_violation__count__corner:min_ss_100C_1v60 | 4824
design__max_fanout_violation__count__corner:min_ss_100C_1v60 | 102
design__max_cap_violation__count__corner:min_ss_100C_1v60 | 26
clock__skew__worst_hold__corner:min_ss_100C_1v60 | -0.7934405579359355
clock__skew__worst_setup__corner:min_ss_100C_1v60 | 0.5608093037580273
timing__hold__ws__corner:min_ss_100C_1v60 | -0.3816724822000713
timing__setup__ws__corner:min_ss_100C_1v60 | -2.2215616641755114
timing__hold__tns__corner:min_ss_100C_1v60 | -4.448825433966764
timing__setup__tns__corner:min_ss_100C_1v60 | -248.33554582284683
timing__hold__wns__corner:min_ss_100C_1v60 | -0.3816724822000713
timing__setup__wns__corner:min_ss_100C_1v60 | -2.2215616641755114
timing__hold_vio__count__corner:min_ss_100C_1v60 | 20
timing__hold_r2r__ws__corner:min_ss_100C_1v60 | 0.842281
timing__hold_r2r_vio__count__corner:min_ss_100C_1v60 | 0
timing__setup_vio__count__corner:min_ss_100C_1v60 | 419
timing__setup_r2r__ws__corner:min_ss_100C_1v60 | -2.221562
timing__setup_r2r_vio__count__corner:min_ss_100C_1v60 | 418
timing__unannotated_net__count__corner:min_ss_100C_1v60 | 239
timing__unannotated_net_filtered__count__corner:min_ss_100C_1v60 | 0
design__max_slew_violation__count__corner:min_ff_n40C_1v95 | 148
design__max_fanout_violation__count__corner:min_ff_n40C_1v95 | 102
design__max_cap_violation__count__corner:min_ff_n40C_1v95 | 3
clock__skew__worst_hold__corner:min_ff_n40C_1v95 | -0.46435587245269033
clock__skew__worst_setup__corner:min_ff_n40C_1v95 | 0.37001783240272584
timing__hold__ws__corner:min_ff_n40C_1v95 | 0.10676138053572481
timing__setup__ws__corner:min_ff_n40C_1v95 | 5.397070498830991
timing__hold__tns__corner:min_ff_n40C_1v95 | 0.0
timing__setup__tns__corner:min_ff_n40C_1v95 | 0.0
timing__hold__wns__corner:min_ff_n40C_1v95 | 0
timing__setup__wns__corner:min_ff_n40C_1v95 | 0.0
timing__hold_vio__count__corner:min_ff_n40C_1v95 | 0
timing__hold_r2r__ws__corner:min_ff_n40C_1v95 | 0.106761
timing__hold_r2r_vio__count__corner:min_ff_n40C_1v95 | 0
timing__setup_vio__count__corner:min_ff_n40C_1v95 | 0
timing__setup_r2r__ws__corner:min_ff_n40C_1v95 | 5.747179
timing__setup_r2r_vio__count__corner:min_ff_n40C_1v95 | 0
timing__unannotated_net__count__corner:min_ff_n40C_1v95 | 239
timing__unannotated_net_filtered__count__corner:min_ff_n40C_1v95 | 0
design__max_slew_violation__count__corner:max_tt_025C_1v80 | 1882
design__max_fanout_violation__count__corner:max_tt_025C_1v80 | 102
design__max_cap_violation__count__corner:max_tt_025C_1v80 | 4
clock__skew__worst_hold__corner:max_tt_025C_1v80 | -0.5984191089816046
clock__skew__worst_setup__corner:max_tt_025C_1v80 | 0.4474780950215489
timing__hold__ws__corner:max_tt_025C_1v80 | 0.30724068603347165
timing__setup__ws__corner:max_tt_025C_1v80 | 2.9966110441214857
timing__hold__tns__corner:max_tt_025C_1v80 | 0.0
timing__setup__tns__corner:max_tt_025C_1v80 | 0.0
timing__hold__wns__corner:max_tt_025C_1v80 | 0
timing__setup__wns__corner:max_tt_025C_1v80 | 0.0
timing__hold_vio__count__corner:max_tt_025C_1v80 | 0
timing__hold_r2r__ws__corner:max_tt_025C_1v80 | 0.307241
timing__hold_r2r_vio__count__corner:max_tt_025C_1v80 | 0
timing__setup_vio__count__corner:max_tt_025C_1v80 | 0
timing__setup_r2r__ws__corner:max_tt_025C_1v80 | 2.996611
timing__setup_r2r_vio__count__corner:max_tt_025C_1v80 | 0
timing__unannotated_net__count__corner:max_tt_025C_1v80 | 239
timing__unannotated_net_filtered__count__corner:max_tt_025C_1v80 | 0
design__max_slew_violation__count__corner:max_ss_100C_1v60 | 6251
design__max_fanout_violation__count__corner:max_ss_100C_1v60 | 102
design__max_cap_violation__count__corner:max_ss_100C_1v60 | 58
clock__skew__worst_hold__corner:max_ss_100C_1v60 | -0.8578478170627739
clock__skew__worst_setup__corner:max_ss_100C_1v60 | 0.5999572120034208
timing__hold__ws__corner:max_ss_100C_1v60 | -0.6459903905753609
timing__setup__ws__corner:max_ss_100C_1v60 | -3.124993685606369
timing__hold__tns__corner:max_ss_100C_1v60 | -9.896907573597518
timing__setup__tns__corner:max_ss_100C_1v60 | -741.7118222879277
timing__hold__wns__corner:max_ss_100C_1v60 | -0.6459903905753609
timing__setup__wns__corner:max_ss_100C_1v60 | -3.124993685606369
timing__hold_vio__count__corner:max_ss_100C_1v60 | 21
timing__hold_r2r__ws__corner:max_ss_100C_1v60 | 0.858129
timing__hold_r2r_vio__count__corner:max_ss_100C_1v60 | 0
timing__setup_vio__count__corner:max_ss_100C_1v60 | 1101
timing__setup_r2r__ws__corner:max_ss_100C_1v60 | -3.124994
timing__setup_r2r_vio__count__corner:max_ss_100C_1v60 | 1100
timing__unannotated_net__count__corner:max_ss_100C_1v60 | 239
timing__unannotated_net_filtered__count__corner:max_ss_100C_1v60 | 0
design__max_slew_violation__count__corner:max_ff_n40C_1v95 | 392
design__max_fanout_violation__count__corner:max_ff_n40C_1v95 | 102
design__max_cap_violation__count__corner:max_ff_n40C_1v95 | 4
clock__skew__worst_hold__corner:max_ff_n40C_1v95 | -0.4904388145526706
clock__skew__worst_setup__corner:max_ff_n40C_1v95 | 0.3856301220834579
timing__hold__ws__corner:max_ff_n40C_1v95 | 0.1059831141734517
timing__setup__ws__corner:max_ff_n40C_1v95 | 5.219819835222914
timing__hold__tns__corner:max_ff_n40C_1v95 | 0.0
timing__setup__tns__corner:max_ff_n40C_1v95 | 0.0
timing__hold__wns__corner:max_ff_n40C_1v95 | 0
timing__setup__wns__corner:max_ff_n40C_1v95 | 0.0
timing__hold_vio__count__corner:max_ff_n40C_1v95 | 0
timing__hold_r2r__ws__corner:max_ff_n40C_1v95 | 0.105983
timing__hold_r2r_vio__count__corner:max_ff_n40C_1v95 | 0
timing__setup_vio__count__corner:max_ff_n40C_1v95 | 0
timing__setup_r2r__ws__corner:max_ff_n40C_1v95 | 5.410143
timing__setup_r2r_vio__count__corner:max_ff_n40C_1v95 | 0
timing__unannotated_net__count__corner:max_ff_n40C_1v95 | 239
timing__unannotated_net_filtered__count__corner:max_ff_n40C_1v95 | 0
timing__unannotated_net__count | 239
timing__unannotated_net_filtered__count | 0
design_powergrid__voltage__worst__net:VPWR__corner:nom_tt_025C_1v80 | 1.79887
design_powergrid__drop__average__net:VPWR__corner:nom_tt_025C_1v80 | 1.79986
design_powergrid__drop__worst__net:VPWR__corner:nom_tt_025C_1v80 | 0.00113332
design_powergrid__voltage__worst__net:VGND__corner:nom_tt_025C_1v80 | 0.000888273
design_powergrid__drop__average__net:VGND__corner:nom_tt_025C_1v80 | 0.000138014
design_powergrid__drop__worst__net:VGND__corner:nom_tt_025C_1v80 | 0.000888273
design_powergrid__voltage__worst | 0.000888273
design_powergrid__voltage__worst__net:VPWR | 1.79887
design_powergrid__drop__worst | 0.00113332
design_powergrid__drop__worst__net:VPWR | 0.00113332
design_powergrid__voltage__worst__net:VGND | 0.000888273
design_powergrid__drop__worst__net:VGND | 0.000888273
ir__voltage__worst | 1.8000000000000000444089209850062616169452667236328125
ir__drop__avg | 0.00013899999999999999053361399159456368579412810504436492919921875
ir__drop__worst | 0.001129999999999999928113059155521114007569849491119384765625
design__xor_difference__count | 0
magic__drc_error__count | 0
klayout__drc_error__count | 0
magic__illegal_overlap__count | 0
design__lvs_device_difference__count | 0
design__lvs_net_difference__count | 0
design__lvs_property_fail__count | 0
design__lvs_error__count | 0
design__lvs_unmatched_device__count | 0
design__lvs_unmatched_net__count | 0
design__lvs_unmatched_pin__count | 0
