ydss0857/stream-conv-engine-rtl-to-gds/asic/results/w128_80mhz_v4b/metrics.csv

Metric | Value
design__lint_error__count | 0
design__lint_timing_construct__count | 0
design__lint_warning__count | 468
design__inferred_latch__count | 0
design__instance__count | 111893
design__instance__area | 559474
design__instance_unmapped__count | 0
synthesis__check_error__count | 0
design__max_slew_violation__count__corner:nom_tt_025C_1v80 | 1833
design__max_fanout_violation__count__corner:nom_tt_025C_1v80 | 103
design__max_cap_violation__count__corner:nom_tt_025C_1v80 | 4
power__internal__total | 0.02017715387046337
power__switching__total | 0.00726119801402092
power__leakage__total | 6.024094432177662E-7
power__total | 0.027438953518867493
clock__skew__worst_hold__corner:nom_tt_025C_1v80 | -0.5800351474415076
clock__skew__worst_setup__corner:nom_tt_025C_1v80 | 0.4309744627602876
timing__hold__ws__corner:nom_tt_025C_1v80 | 0.302871292174182
timing__setup__ws__corner:nom_tt_025C_1v80 | 5.284458353812322
timing__hold__tns__corner:nom_tt_025C_1v80 | 0.0
timing__setup__tns__corner:nom_tt_025C_1v80 | 0.0
timing__hold__wns__corner:nom_tt_025C_1v80 | 0
timing__setup__wns__corner:nom_tt_025C_1v80 | 0.0
timing__hold_vio__count__corner:nom_tt_025C_1v80 | 0
timing__hold_r2r__ws__corner:nom_tt_025C_1v80 | 0.302871
timing__hold_r2r_vio__count__corner:nom_tt_025C_1v80 | 0
timing__setup_vio__count__corner:nom_tt_025C_1v80 | 0
timing__setup_r2r__ws__corner:nom_tt_025C_1v80 | 5.284458
timing__setup_r2r_vio__count__corner:nom_tt_025C_1v80 | 0
design__max_slew_violation__count__corner:nom_ss_100C_1v60 | 8509
design__max_fanout_violation__count__corner:nom_ss_100C_1v60 | 103
design__max_cap_violation__count__corner:nom_ss_100C_1v60 | 50
clock__skew__worst_hold__corner:nom_ss_100C_1v60 | -0.8295953048222872
clock__skew__worst_setup__corner:nom_ss_100C_1v60 | 0.577989450438477
timing__hold__ws__corner:nom_ss_100C_1v60 | -0.19863333762249508
timing__setup__ws__corner:nom_ss_100C_1v60 | -1.576578912045798
timing__hold__tns__corner:nom_ss_100C_1v60 | -5.285918519175606
timing__setup__tns__corner:nom_ss_100C_1v60 | -42.06419154278705
timing__hold__wns__corner:nom_ss_100C_1v60 | -0.19863333762249508
timing__setup__wns__corner:nom_ss_100C_1v60 | -1.576578912045798
timing__hold_vio__count__corner:nom_ss_100C_1v60 | 41
timing__hold_r2r__ws__corner:nom_ss_100C_1v60 | 0.847893
timing__hold_r2r_vio__count__corner:nom_ss_100C_1v60 | 0
timing__setup_vio__count__corner:nom_ss_100C_1v60 | 87
timing__setup_r2r__ws__corner:nom_ss_100C_1v60 | -1.576579
timing__setup_r2r_vio__count__corner:nom_ss_100C_1v60 | 87
design__max_slew_violation__count__corner:nom_ff_n40C_1v95 | 301
design__max_fanout_violation__count__corner:nom_ff_n40C_1v95 | 103
design__max_cap_violation__count__corner:nom_ff_n40C_1v95 | 4
clock__skew__worst_hold__corner:nom_ff_n40C_1v95 | -0.4784632825365577
clock__skew__worst_setup__corner:nom_ff_n40C_1v95 | 0.37486975695774016
timing__hold__ws__corner:nom_ff_n40C_1v95 | 0.10751566607998779
timing__setup__ws__corner:nom_ff_n40C_1v95 | 7.324062896800659
timing__hold__tns__corner:nom_ff_n40C_1v95 | 0.0
timing__setup__tns__corner:nom_ff_n40C_1v95 | 0.0
timing__hold__wns__corner:nom_ff_n40C_1v95 | 0
timing__setup__wns__corner:nom_ff_n40C_1v95 | 0.0
timing__hold_vio__count__corner:nom_ff_n40C_1v95 | 0
timing__hold_r2r__ws__corner:nom_ff_n40C_1v95 | 0.107516
timing__hold_r2r_vio__count__corner:nom_ff_n40C_1v95 | 0
timing__setup_vio__count__corner:nom_ff_n40C_1v95 | 0
timing__setup_r2r__ws__corner:nom_ff_n40C_1v95 | 7.832810
timing__setup_r2r_vio__count__corner:nom_ff_n40C_1v95 | 0
design__max_slew_violation__count | 9182
design__max_fanout_violation__count | 103
design__max_cap_violation__count | 63
clock__skew__worst_hold | -0.46375071762042785
clock__skew__worst_setup | 0.3659903039779625
timing__hold__ws | -0.33992609689205266
timing__setup__ws | -1.9468232021963765
timing__hold__tns | -11.931589387555443
timing__setup__tns | -73.06300837807625
timing__hold__wns | -0.33992609689205266
timing__setup__wns | -1.9468232021963765
timing__hold_vio__count | 122
timing__hold_r2r__ws | 0.101735
timing__hold_r2r_vio__count | 0
timing__setup_vio__count | 260
timing__setup_r2r__ws | -1.946823
timing__setup_r2r_vio__count | 260
design__die__bbox | 0.0 0.0 759.22 769.94
design__core__bbox | 5.52 10.88 753.48 758.88
design__io | 154
design__die__area | 584554
design__core__area | 559474
design__instance__count__stdcell | 32800
design__instance__area__stdcell | 291087
design__instance__count__macros | 0
design__instance__area__macros | 0
design__instance__count__padcells | 0
design__instance__area__padcells | 0
design__instance__count__cover | 0
design__instance__area__cover | 0
design__instance__utilization | 0.520286
design__instance__utilization__stdcell | 0.520286
design__rows | 275
design__rows:unithd | 275
design__sites | 447150
design__sites:unithd | 447150
design__instance__count__class:buffer | 18
design__instance__area__class:buffer | 90.0864
design__instance__count__class:inverter | 197
design__instance__area__class:inverter | 739.459
design__instance__count__class:sequential_cell | 3745
design__instance__area__class:sequential_cell | 79657.6
design__instance__count__class:multi_input_combinational_cell | 13942
design__instance__area__class:multi_input_combinational_cell | 143411
flow__warnings__count | 1
flow__errors__count | 0
flow__warnings__count:ODB-0220 | 2
flow__warnings__type_count | 1
flow__warnings__count:ORD-0039 | 1
design__instance__count__class:fill_cell | 79093
design__instance__area__class:fill_cell | 268387
design__instance__count__class:tap_cell | 7894
design__instance__area__class:tap_cell | 9876.97
design__power_grid_violation__count__net:VGND | 0
design__power_grid_violation__count__net:VPWR | 0
design__power_grid_violation__count | 0
floorplan__design__io | 152
design__io__hpwl | 30489223
flow__warnings__count:GRT-0281 | 1
timing__drv__floating__nets | 2
timing__drv__floating__pins | 0
design__instance__displacement__total | 15517.1
design__instance__displacement__mean | 0.466
design__instance__displacement__max | 15.52
route__wirelength__estimated | 693199
design__violations | 0
design__instance__count__class:timing_repair_buffer | 6243
design__instance__area__class:timing_repair_buffer | 48351.4
flow__warnings__count:RSZ-0020 | 1
flow__warnings__count:STA-1140 | 6
design__instance__count__class:clock_buffer | 613
design__instance__area__class:clock_buffer | 8197.86
design__instance__count__class:clock_inverter | 63
design__instance__area__class:clock_inverter | 549.277
design__instance__count__setup_buffer | 0
design__instance__count__hold_buffer | 3651
global_route__vias | 23
global_route__wirelength | 1116633
antenna__violating__nets | 1
antenna__violating__pins | 2
route__antenna_violation__count | 1
antenna_diodes_count | 39
design__instance__count__class:antenna_cell | 85
design__instance__area__class:antenna_cell | 212.704
route__net | 24687
route__net__special | 2
route__drc_errors__iter:0 | 65
route__wirelength__iter:0 | 775776
route__drc_errors__iter:1 | 50
route__wirelength__iter:1 | 775766
route__drc_errors__iter:2 | 27
route__wirelength__iter:2 | 775769
route__drc_errors__iter:3 | 0
route__wirelength__iter:3 | 775751
route__drc_errors__iter:4 | 0
route__wirelength__iter:4 | 775713
route__drc_errors | 0
route__wirelength | 775751
route__vias | 169414
route__vias__singlecut | 169414
route__vias__multicut | 0
flow__warnings__count:DRT-0349 | 10
design__disconnected_pin__count | 13
design__critical_disconnected_pin__count | 0
route__wirelength__max | 1121.11
timing__unannotated_net__count__corner:nom_tt_025C_1v80 | 239
timing__unannotated_net_filtered__count__corner:nom_tt_025C_1v80 | 0
timing__unannotated_net__count__corner:nom_ss_100C_1v60 | 239
timing__unannotated_net_filtered__count__corner:nom_ss_100C_1v60 | 0
timing__unannotated_net__count__corner:nom_ff_n40C_1v95 | 239
timing__unannotated_net_filtered__count__corner:nom_ff_n40C_1v95 | 0
design__max_slew_violation__count__corner:min_tt_025C_1v80 | 1387
design__max_fanout_violation__count__corner:min_tt_025C_1v80 | 103
design__max_cap_violation__count__corner:min_tt_025C_1v80 | 3
clock__skew__worst_hold__corner:min_tt_025C_1v80 | -0.5569502794375921
clock__skew__worst_setup__corner:min_tt_025C_1v80 | 0.41649249117289405
timing__hold__ws__corner:min_tt_025C_1v80 | 0.3049994787502752
timing__setup__ws__corner:min_tt_025C_1v80 | 5.486465659302076
timing__hold__tns__corner:min_tt_025C_1v80 | 0.0
timing__setup__tns__corner:min_tt_025C_1v80 | 0.0
timing__hold__wns__corner:min_tt_025C_1v80 | 0
timing__setup__wns__corner:min_tt_025C_1v80 | 0.0
timing__hold_vio__count__corner:min_tt_025C_1v80 | 0
timing__hold_r2r__ws__corner:min_tt_025C_1v80 | 0.304999
timing__hold_r2r_vio__count__corner:min_tt_025C_1v80 | 0
timing__setup_vio__count__corner:min_tt_025C_1v80 | 0
timing__setup_r2r__ws__corner:min_tt_025C_1v80 | 5.486465
timing__setup_r2r_vio__count__corner:min_tt_025C_1v80 | 0
timing__unannotated_net__count__corner:min_tt_025C_1v80 | 239
timing__unannotated_net_filtered__count__corner:min_tt_025C_1v80 | 0
design__max_slew_violation__count__corner:min_ss_100C_1v60 | 7547
design__max_fanout_violation__count__corner:min_ss_100C_1v60 | 103
design__max_cap_violation__count__corner:min_ss_100C_1v60 | 32
clock__skew__worst_hold__corner:min_ss_100C_1v60 | -0.791327248348793
clock__skew__worst_setup__corner:min_ss_100C_1v60 | 0.5555762673834562
timing__hold__ws__corner:min_ss_100C_1v60 | -0.05799538791138066
timing__setup__ws__corner:min_ss_100C_1v60 | -1.1936389992049692
timing__hold__tns__corner:min_ss_100C_1v60 | -0.5575700059474649
timing__setup__tns__corner:min_ss_100C_1v60 | -21.20471680485798
timing__hold__wns__corner:min_ss_100C_1v60 | -0.05799538791138066
timing__setup__wns__corner:min_ss_100C_1v60 | -1.1936389992049692
timing__hold_vio__count__corner:min_ss_100C_1v60 | 19
timing__hold_r2r__ws__corner:min_ss_100C_1v60 | 0.840837
timing__hold_r2r_vio__count__corner:min_ss_100C_1v60 | 0
timing__setup_vio__count__corner:min_ss_100C_1v60 | 53
timing__setup_r2r__ws__corner:min_ss_100C_1v60 | -1.193639
timing__setup_r2r_vio__count__corner:min_ss_100C_1v60 | 53
timing__unannotated_net__count__corner:min_ss_100C_1v60 | 239
timing__unannotated_net_filtered__count__corner:min_ss_100C_1v60 | 0
design__max_slew_violation__count__corner:min_ff_n40C_1v95 | 162
design__max_fanout_violation__count__corner:min_ff_n40C_1v95 | 103
design__max_cap_violation__count__corner:min_ff_n40C_1v95 | 3
clock__skew__worst_hold__corner:min_ff_n40C_1v95 | -0.46375071762042785
clock__skew__worst_setup__corner:min_ff_n40C_1v95 | 0.3659903039779625
timing__hold__ws__corner:min_ff_n40C_1v95 | 0.10750822758551243
timing__setup__ws__corner:min_ff_n40C_1v95 | 7.408097012178814
timing__hold__tns__corner:min_ff_n40C_1v95 | 0.0
timing__setup__tns__corner:min_ff_n40C_1v95 | 0.0
timing__hold__wns__corner:min_ff_n40C_1v95 | 0
timing__setup__wns__corner:min_ff_n40C_1v95 | 0.0
timing__hold_vio__count__corner:min_ff_n40C_1v95 | 0
timing__hold_r2r__ws__corner:min_ff_n40C_1v95 | 0.107508
timing__hold_r2r_vio__count__corner:min_ff_n40C_1v95 | 0
timing__setup_vio__count__corner:min_ff_n40C_1v95 | 0
timing__setup_r2r__ws__corner:min_ff_n40C_1v95 | 7.982937
timing__setup_r2r_vio__count__corner:min_ff_n40C_1v95 | 0
timing__unannotated_net__count__corner:min_ff_n40C_1v95 | 239
timing__unannotated_net_filtered__count__corner:min_ff_n40C_1v95 | 0
design__max_slew_violation__count__corner:max_tt_025C_1v80 | 2377
design__max_fanout_violation__count__corner:max_tt_025C_1v80 | 103
design__max_cap_violation__count__corner:max_tt_025C_1v80 | 4
clock__skew__worst_hold__corner:max_tt_025C_1v80 | -0.5981812992030042
clock__skew__worst_setup__corner:max_tt_025C_1v80 | 0.44221463853524273
timing__hold__ws__corner:max_tt_025C_1v80 | 0.30389203125189085
timing__setup__ws__corner:max_tt_025C_1v80 | 5.0874399466471205
timing__hold__tns__corner:max_tt_025C_1v80 | 0.0
timing__setup__tns__corner:max_tt_025C_1v80 | 0.0
timing__hold__wns__corner:max_tt_025C_1v80 | 0
timing__setup__wns__corner:max_tt_025C_1v80 | 0.0
timing__hold_vio__count__corner:max_tt_025C_1v80 | 0
timing__hold_r2r__ws__corner:max_tt_025C_1v80 | 0.303892
timing__hold_r2r_vio__count__corner:max_tt_025C_1v80 | 0
timing__setup_vio__count__corner:max_tt_025C_1v80 | 0
timing__setup_r2r__ws__corner:max_tt_025C_1v80 | 5.087440
timing__setup_r2r_vio__count__corner:max_tt_025C_1v80 | 0
timing__unannotated_net__count__corner:max_tt_025C_1v80 | 239
timing__unannotated_net_filtered__count__corner:max_tt_025C_1v80 | 0
design__max_slew_violation__count__corner:max_ss_100C_1v60 | 9182
design__max_fanout_violation__count__corner:max_ss_100C_1v60 | 103
design__max_cap_violation__count__corner:max_ss_100C_1v60 | 63
clock__skew__worst_hold__corner:max_ss_100C_1v60 | -0.8539822424263082
clock__skew__worst_setup__corner:max_ss_100C_1v60 | 0.5834182191378252
timing__hold__ws__corner:max_ss_100C_1v60 | -0.33992609689205266
timing__setup__ws__corner:max_ss_100C_1v60 | -1.9468232021963765
timing__hold__tns__corner:max_ss_100C_1v60 | -11.931589387555443
timing__setup__tns__corner:max_ss_100C_1v60 | -73.06300837807625
timing__hold__wns__corner:max_ss_100C_1v60 | -0.33992609689205266
timing__setup__wns__corner:max_ss_100C_1v60 | -1.9468232021963765
timing__hold_vio__count__corner:max_ss_100C_1v60 | 62
timing__hold_r2r__ws__corner:max_ss_100C_1v60 | 0.855364
timing__hold_r2r_vio__count__corner:max_ss_100C_1v60 | 0
timing__setup_vio__count__corner:max_ss_100C_1v60 | 120
timing__setup_r2r__ws__corner:max_ss_100C_1v60 | -1.946823
timing__setup_r2r_vio__count__corner:max_ss_100C_1v60 | 120
timing__unannotated_net__count__corner:max_ss_100C_1v60 | 239
timing__unannotated_net_filtered__count__corner:max_ss_100C_1v60 | 0
design__max_slew_violation__count__corner:max_ff_n40C_1v95 | 442
design__max_fanout_violation__count__corner:max_ff_n40C_1v95 | 103
design__max_cap_violation__count__corner:max_ff_n40C_1v95 | 4
clock__skew__worst_hold__corner:max_ff_n40C_1v95 | -0.490975718422564
clock__skew__worst_setup__corner:max_ff_n40C_1v95 | 0.38242970983543273
timing__hold__ws__corner:max_ff_n40C_1v95 | 0.10173451258265749
timing__setup__ws__corner:max_ff_n40C_1v95 | 7.228067238216897
timing__hold__tns__corner:max_ff_n40C_1v95 | 0.0
timing__setup__tns__corner:max_ff_n40C_1v95 | 0.0
timing__hold__wns__corner:max_ff_n40C_1v95 | 0
timing__setup__wns__corner:max_ff_n40C_1v95 | 0.0
timing__hold_vio__count__corner:max_ff_n40C_1v95 | 0
timing__hold_r2r__ws__corner:max_ff_n40C_1v95 | 0.101735
timing__hold_r2r_vio__count__corner:max_ff_n40C_1v95 | 0
timing__setup_vio__count__corner:max_ff_n40C_1v95 | 0
timing__setup_r2r__ws__corner:max_ff_n40C_1v95 | 7.664612
timing__setup_r2r_vio__count__corner:max_ff_n40C_1v95 | 0
timing__unannotated_net__count__corner:max_ff_n40C_1v95 | 239
timing__unannotated_net_filtered__count__corner:max_ff_n40C_1v95 | 0
timing__unannotated_net__count | 239
timing__unannotated_net_filtered__count | 0
design_powergrid__voltage__worst__net:VPWR__corner:nom_tt_025C_1v80 | 1.79909
design_powergrid__drop__average__net:VPWR__corner:nom_tt_025C_1v80 | 1.79989
design_powergrid__drop__worst__net:VPWR__corner:nom_tt_025C_1v80 | 0.000907509
design_powergrid__voltage__worst__net:VGND__corner:nom_tt_025C_1v80 | 0.00070851
design_powergrid__drop__average__net:VGND__corner:nom_tt_025C_1v80 | 0.000110311
design_powergrid__drop__worst__net:VGND__corner:nom_tt_025C_1v80 | 0.00070851
design_powergrid__voltage__worst | 0.00070851
design_powergrid__voltage__worst__net:VPWR | 1.79909
design_powergrid__drop__worst | 0.000907509
design_powergrid__drop__worst__net:VPWR | 0.000907509
design_powergrid__voltage__worst__net:VGND | 0.00070851
design_powergrid__drop__worst__net:VGND | 0.00070851
ir__voltage__worst | 1.8000000000000000444089209850062616169452667236328125
ir__drop__avg | 0.000111000000000000001118029280267052172348485328257083892822265625
ir__drop__worst | 0.000907999999999999952982054907124620513059198856353759765625
design__xor_difference__count | 0
magic__drc_error__count | 0
klayout__drc_error__count | 0
magic__illegal_overlap__count | 0
design__lvs_device_difference__count | 0
design__lvs_net_difference__count | 0
design__lvs_property_fail__count | 0
design__lvs_error__count | 0
design__lvs_unmatched_device__count | 0
design__lvs_unmatched_net__count | 0
design__lvs_unmatched_pin__count | 0
