ydss0857/stream-conv-engine-rtl-to-gds/asic/results/w128_80mhz_v5/metrics.csv

Metric | Value
design__lint_error__count | 0
design__lint_timing_construct__count | 0
design__lint_warning__count | 469
design__inferred_latch__count | 0
design__instance__count | 111842
design__instance__area | 559474
design__instance_unmapped__count | 0
synthesis__check_error__count | 0
design__max_slew_violation__count__corner:nom_tt_025C_1v80 | 1763
design__max_fanout_violation__count__corner:nom_tt_025C_1v80 | 96
design__max_cap_violation__count__corner:nom_tt_025C_1v80 | 4
power__internal__total | 0.02046055532991886
power__switching__total | 0.007284663617610931
power__leakage__total | 6.034253487996466E-7
power__total | 0.027745822444558144
clock__skew__worst_hold__corner:nom_tt_025C_1v80 | -0.5862979157005413
clock__skew__worst_setup__corner:nom_tt_025C_1v80 | 0.42426283131970327
timing__hold__ws__corner:nom_tt_025C_1v80 | 0.31917380752884444
timing__setup__ws__corner:nom_tt_025C_1v80 | 3.9016693202848076
timing__hold__tns__corner:nom_tt_025C_1v80 | 0.0
timing__setup__tns__corner:nom_tt_025C_1v80 | 0.0
timing__hold__wns__corner:nom_tt_025C_1v80 | 0
timing__setup__wns__corner:nom_tt_025C_1v80 | 0.0
timing__hold_vio__count__corner:nom_tt_025C_1v80 | 0
timing__hold_r2r__ws__corner:nom_tt_025C_1v80 | 0.319174
timing__hold_r2r_vio__count__corner:nom_tt_025C_1v80 | 0
timing__setup_vio__count__corner:nom_tt_025C_1v80 | 0
timing__setup_r2r__ws__corner:nom_tt_025C_1v80 | 3.901669
timing__setup_r2r_vio__count__corner:nom_tt_025C_1v80 | 0
design__max_slew_violation__count__corner:nom_ss_100C_1v60 | 8166
design__max_fanout_violation__count__corner:nom_ss_100C_1v60 | 96
design__max_cap_violation__count__corner:nom_ss_100C_1v60 | 56
clock__skew__worst_hold__corner:nom_ss_100C_1v60 | -0.8075027541858463
clock__skew__worst_setup__corner:nom_ss_100C_1v60 | 0.549889482845888
timing__hold__ws__corner:nom_ss_100C_1v60 | 0.8373553198946754
timing__setup__ws__corner:nom_ss_100C_1v60 | -3.5378030395464783
timing__hold__tns__corner:nom_ss_100C_1v60 | 0.0
timing__setup__tns__corner:nom_ss_100C_1v60 | -391.43106930356487
timing__hold__wns__corner:nom_ss_100C_1v60 | 0
timing__setup__wns__corner:nom_ss_100C_1v60 | -3.5378030395464783
timing__hold_vio__count__corner:nom_ss_100C_1v60 | 0
timing__hold_r2r__ws__corner:nom_ss_100C_1v60 | 0.879244
timing__hold_r2r_vio__count__corner:nom_ss_100C_1v60 | 0
timing__setup_vio__count__corner:nom_ss_100C_1v60 | 263
timing__setup_r2r__ws__corner:nom_ss_100C_1v60 | -3.537803
timing__setup_r2r_vio__count__corner:nom_ss_100C_1v60 | 263
design__max_slew_violation__count__corner:nom_ff_n40C_1v95 | 320
design__max_fanout_violation__count__corner:nom_ff_n40C_1v95 | 96
design__max_cap_violation__count__corner:nom_ff_n40C_1v95 | 4
clock__skew__worst_hold__corner:nom_ff_n40C_1v95 | -0.49444960636486435
clock__skew__worst_setup__corner:nom_ff_n40C_1v95 | 0.3751269678842446
timing__hold__ws__corner:nom_ff_n40C_1v95 | 0.0942480564712737
timing__setup__ws__corner:nom_ff_n40C_1v95 | 6.770443064486529
timing__hold__tns__corner:nom_ff_n40C_1v95 | 0.0
timing__setup__tns__corner:nom_ff_n40C_1v95 | 0.0
timing__hold__wns__corner:nom_ff_n40C_1v95 | 0
timing__setup__wns__corner:nom_ff_n40C_1v95 | 0.0
timing__hold_vio__count__corner:nom_ff_n40C_1v95 | 0
timing__hold_r2r__ws__corner:nom_ff_n40C_1v95 | 0.094248
timing__hold_r2r_vio__count__corner:nom_ff_n40C_1v95 | 0
timing__setup_vio__count__corner:nom_ff_n40C_1v95 | 0
timing__setup_r2r__ws__corner:nom_ff_n40C_1v95 | 6.770443
timing__setup_r2r_vio__count__corner:nom_ff_n40C_1v95 | 0
design__max_slew_violation__count | 8817
design__max_fanout_violation__count | 96
design__max_cap_violation__count | 75
clock__skew__worst_hold | -0.4733366055307538
clock__skew__worst_setup | 0.3633608516920743
timing__hold__ws | 0.07638312420986813
timing__setup__ws | -4.2081646025584645
timing__hold__tns | 0.0
timing__setup__tns | -527.4915942236871
timing__hold__wns | 0
timing__setup__wns | -4.2081646025584645
timing__hold_vio__count | 0
timing__hold_r2r__ws | 0.076383
timing__hold_r2r_vio__count | 0
timing__setup_vio__count | 776
timing__setup_r2r__ws | -4.208165
timing__setup_r2r_vio__count | 776
design__die__bbox | 0.0 0.0 759.105 769.825
design__core__bbox | 5.52 10.88 753.48 758.88
design__io | 154
design__die__area | 584378
design__core__area | 559474
design__instance__count__stdcell | 32850
design__instance__area__stdcell | 291662
design__instance__count__macros | 0
design__instance__area__macros | 0
design__instance__count__padcells | 0
design__instance__area__padcells | 0
design__instance__count__cover | 0
design__instance__area__cover | 0
design__instance__utilization | 0.521315
design__instance__utilization__stdcell | 0.521315
design__rows | 275
design__rows:unithd | 275
design__sites | 447150
design__sites:unithd | 447150
design__instance__count__class:buffer | 18
design__instance__area__class:buffer | 90.0864
design__instance__count__class:inverter | 186
design__instance__area__class:inverter | 698.17
design__instance__count__class:sequential_cell | 3749
design__instance__area__class:sequential_cell | 79742.7
design__instance__count__class:multi_input_combinational_cell | 13969
design__instance__area__class:multi_input_combinational_cell | 143296
flow__warnings__count | 1
flow__errors__count | 0
flow__warnings__count:ODB-0220 | 2
flow__warnings__type_count | 1
flow__warnings__count:ORD-0039 | 1
design__instance__count__class:fill_cell | 78992
design__instance__area__class:fill_cell | 267812
design__instance__count__class:tap_cell | 7894
design__instance__area__class:tap_cell | 9876.97
design__power_grid_violation__count__net:VGND | 0
design__power_grid_violation__count__net:VPWR | 0
design__power_grid_violation__count | 0
floorplan__design__io | 152
design__io__hpwl | 26889950
flow__warnings__count:GRT-0281 | 1
timing__drv__floating__nets | 2
timing__drv__floating__pins | 0
design__instance__displacement__total | 16224.5
design__instance__displacement__mean | 0.486
design__instance__displacement__max | 23.22
route__wirelength__estimated | 693929
design__violations | 0
design__instance__count__class:timing_repair_buffer | 6288
design__instance__area__class:timing_repair_buffer | 48779.3
flow__warnings__count:RSZ-0020 | 1
flow__warnings__count:STA-1140 | 6
design__instance__count__class:clock_buffer | 610
design__instance__area__class:clock_buffer | 8150.32
design__instance__count__class:clock_inverter | 60
design__instance__area__class:clock_inverter | 838.304
design__instance__count__setup_buffer | 0
design__instance__count__hold_buffer | 400
global_route__vias | 33
global_route__wirelength | 1122533
antenna__violating__nets | 0
antenna__violating__pins | 0
route__antenna_violation__count | 0
antenna_diodes_count | 55
design__instance__count__class:antenna_cell | 76
design__instance__area__class:antenna_cell | 190.182
route__net | 24753
route__net__special | 2
route__drc_errors__iter:0 | 52
route__wirelength__iter:0 | 778288
route__drc_errors__iter:1 | 0
route__wirelength__iter:1 | 778276
route__drc_errors__iter:2 | 69
route__wirelength__iter:2 | 778336
route__drc_errors__iter:3 | 0
route__wirelength__iter:3 | 778285
route__drc_errors__iter:4 | 1
route__wirelength__iter:4 | 778205
route__drc_errors__iter:5 | 0
route__wirelength__iter:5 | 778202
route__drc_errors | 0
route__wirelength | 778276
route__vias | 170325
route__vias__singlecut | 170325
route__vias__multicut | 0
flow__warnings__count:DRT-0349 | 10
design__disconnected_pin__count | 13
design__critical_disconnected_pin__count | 0
route__wirelength__max | 1086.41
timing__unannotated_net__count__corner:nom_tt_025C_1v80 | 232
timing__unannotated_net_filtered__count__corner:nom_tt_025C_1v80 | 0
timing__unannotated_net__count__corner:nom_ss_100C_1v60 | 232
timing__unannotated_net_filtered__count__corner:nom_ss_100C_1v60 | 0
timing__unannotated_net__count__corner:nom_ff_n40C_1v95 | 232
timing__unannotated_net_filtered__count__corner:nom_ff_n40C_1v95 | 0
design__max_slew_violation__count__corner:min_tt_025C_1v80 | 1375
design__max_fanout_violation__count__corner:min_tt_025C_1v80 | 96
design__max_cap_violation__count__corner:min_tt_025C_1v80 | 3
clock__skew__worst_hold__corner:min_tt_025C_1v80 | -0.5605446265814711
clock__skew__worst_setup__corner:min_tt_025C_1v80 | 0.4099574962205232
timing__hold__ws__corner:min_tt_025C_1v80 | 0.3151029526493197
timing__setup__ws__corner:min_tt_025C_1v80 | 4.268105989442445
timing__hold__tns__corner:min_tt_025C_1v80 | 0.0
timing__setup__tns__corner:min_tt_025C_1v80 | 0.0
timing__hold__wns__corner:min_tt_025C_1v80 | 0
timing__setup__wns__corner:min_tt_025C_1v80 | 0.0
timing__hold_vio__count__corner:min_tt_025C_1v80 | 0
timing__hold_r2r__ws__corner:min_tt_025C_1v80 | 0.315103
timing__hold_r2r_vio__count__corner:min_tt_025C_1v80 | 0
timing__setup_vio__count__corner:min_tt_025C_1v80 | 0
timing__setup_r2r__ws__corner:min_tt_025C_1v80 | 4.268106
timing__setup_r2r_vio__count__corner:min_tt_025C_1v80 | 0
timing__unannotated_net__count__corner:min_tt_025C_1v80 | 232
timing__unannotated_net_filtered__count__corner:min_tt_025C_1v80 | 0
design__max_slew_violation__count__corner:min_ss_100C_1v60 | 7347
design__max_fanout_violation__count__corner:min_ss_100C_1v60 | 96
design__max_cap_violation__count__corner:min_ss_100C_1v60 | 30
clock__skew__worst_hold__corner:min_ss_100C_1v60 | -0.7756231432213277
clock__skew__worst_setup__corner:min_ss_100C_1v60 | 0.5276425001823541
timing__hold__ws__corner:min_ss_100C_1v60 | 0.8734315740109662
timing__setup__ws__corner:min_ss_100C_1v60 | -2.860251672023678
timing__hold__tns__corner:min_ss_100C_1v60 | 0.0
timing__setup__tns__corner:min_ss_100C_1v60 | -271.11685397424884
timing__hold__wns__corner:min_ss_100C_1v60 | 0
timing__setup__wns__corner:min_ss_100C_1v60 | -2.860251672023678
timing__hold_vio__count__corner:min_ss_100C_1v60 | 0
timing__hold_r2r__ws__corner:min_ss_100C_1v60 | 0.873432
timing__hold_r2r_vio__count__corner:min_ss_100C_1v60 | 0
timing__setup_vio__count__corner:min_ss_100C_1v60 | 220
timing__setup_r2r__ws__corner:min_ss_100C_1v60 | -2.860252
timing__setup_r2r_vio__count__corner:min_ss_100C_1v60 | 220
timing__unannotated_net__count__corner:min_ss_100C_1v60 | 232
timing__unannotated_net_filtered__count__corner:min_ss_100C_1v60 | 0
design__max_slew_violation__count__corner:min_ff_n40C_1v95 | 146
design__max_fanout_violation__count__corner:min_ff_n40C_1v95 | 96
design__max_cap_violation__count__corner:min_ff_n40C_1v95 | 3
clock__skew__worst_hold__corner:min_ff_n40C_1v95 | -0.4733366055307538
clock__skew__worst_setup__corner:min_ff_n40C_1v95 | 0.3633608516920743
timing__hold__ws__corner:min_ff_n40C_1v95 | 0.10373036057047258
timing__setup__ws__corner:min_ff_n40C_1v95 | 7.011806000955458
timing__hold__tns__corner:min_ff_n40C_1v95 | 0.0
timing__setup__tns__corner:min_ff_n40C_1v95 | 0.0
timing__hold__wns__corner:min_ff_n40C_1v95 | 0
timing__setup__wns__corner:min_ff_n40C_1v95 | 0.0
timing__hold_vio__count__corner:min_ff_n40C_1v95 | 0
timing__hold_r2r__ws__corner:min_ff_n40C_1v95 | 0.103730
timing__hold_r2r_vio__count__corner:min_ff_n40C_1v95 | 0
timing__setup_vio__count__corner:min_ff_n40C_1v95 | 0
timing__setup_r2r__ws__corner:min_ff_n40C_1v95 | 7.011806
timing__setup_r2r_vio__count__corner:min_ff_n40C_1v95 | 0
timing__unannotated_net__count__corner:min_ff_n40C_1v95 | 232
timing__unannotated_net_filtered__count__corner:min_ff_n40C_1v95 | 0
design__max_slew_violation__count__corner:max_tt_025C_1v80 | 2278
design__max_fanout_violation__count__corner:max_tt_025C_1v80 | 96
design__max_cap_violation__count__corner:max_tt_025C_1v80 | 5
clock__skew__worst_hold__corner:max_tt_025C_1v80 | -0.6230325320890545
clock__skew__worst_setup__corner:max_tt_025C_1v80 | 0.44684004983125164
timing__hold__ws__corner:max_tt_025C_1v80 | 0.32455272721297707
timing__setup__ws__corner:max_tt_025C_1v80 | 3.535974280128595
timing__hold__tns__corner:max_tt_025C_1v80 | 0.0
timing__setup__tns__corner:max_tt_025C_1v80 | 0.0
timing__hold__wns__corner:max_tt_025C_1v80 | 0
timing__setup__wns__corner:max_tt_025C_1v80 | 0.0
timing__hold_vio__count__corner:max_tt_025C_1v80 | 0
timing__hold_r2r__ws__corner:max_tt_025C_1v80 | 0.324553
timing__hold_r2r_vio__count__corner:max_tt_025C_1v80 | 0
timing__setup_vio__count__corner:max_tt_025C_1v80 | 0
timing__setup_r2r__ws__corner:max_tt_025C_1v80 | 3.535974
timing__setup_r2r_vio__count__corner:max_tt_025C_1v80 | 0
timing__unannotated_net__count__corner:max_tt_025C_1v80 | 232
timing__unannotated_net_filtered__count__corner:max_tt_025C_1v80 | 0
design__max_slew_violation__count__corner:max_ss_100C_1v60 | 8817
design__max_fanout_violation__count__corner:max_ss_100C_1v60 | 96
design__max_cap_violation__count__corner:max_ss_100C_1v60 | 75
clock__skew__worst_hold__corner:max_ss_100C_1v60 | -0.8591223531310899
clock__skew__worst_setup__corner:max_ss_100C_1v60 | 0.5727876113317802
timing__hold__ws__corner:max_ss_100C_1v60 | 0.694535781878473
timing__setup__ws__corner:max_ss_100C_1v60 | -4.2081646025584645
timing__hold__tns__corner:max_ss_100C_1v60 | 0.0
timing__setup__tns__corner:max_ss_100C_1v60 | -527.4915942236871
timing__hold__wns__corner:max_ss_100C_1v60 | 0
timing__setup__wns__corner:max_ss_100C_1v60 | -4.2081646025584645
timing__hold_vio__count__corner:max_ss_100C_1v60 | 0
timing__hold_r2r__ws__corner:max_ss_100C_1v60 | 0.889494
timing__hold_r2r_vio__count__corner:max_ss_100C_1v60 | 0
timing__setup_vio__count__corner:max_ss_100C_1v60 | 293
timing__setup_r2r__ws__corner:max_ss_100C_1v60 | -4.208165
timing__setup_r2r_vio__count__corner:max_ss_100C_1v60 | 293
timing__unannotated_net__count__corner:max_ss_100C_1v60 | 232
timing__unannotated_net_filtered__count__corner:max_ss_100C_1v60 | 0
design__max_slew_violation__count__corner:max_ff_n40C_1v95 | 529
design__max_fanout_violation__count__corner:max_ff_n40C_1v95 | 96
design__max_cap_violation__count__corner:max_ff_n40C_1v95 | 4
clock__skew__worst_hold__corner:max_ff_n40C_1v95 | -0.5242075810693202
clock__skew__worst_setup__corner:max_ff_n40C_1v95 | 0.39511495194010926
timing__hold__ws__corner:max_ff_n40C_1v95 | 0.07638312420986813
timing__setup__ws__corner:max_ff_n40C_1v95 | 6.526148695060473
timing__hold__tns__corner:max_ff_n40C_1v95 | 0.0
timing__setup__tns__corner:max_ff_n40C_1v95 | 0.0
timing__hold__wns__corner:max_ff_n40C_1v95 | 0
timing__setup__wns__corner:max_ff_n40C_1v95 | 0.0
timing__hold_vio__count__corner:max_ff_n40C_1v95 | 0
timing__hold_r2r__ws__corner:max_ff_n40C_1v95 | 0.076383
timing__hold_r2r_vio__count__corner:max_ff_n40C_1v95 | 0
timing__setup_vio__count__corner:max_ff_n40C_1v95 | 0
timing__setup_r2r__ws__corner:max_ff_n40C_1v95 | 6.526149
timing__setup_r2r_vio__count__corner:max_ff_n40C_1v95 | 0
timing__unannotated_net__count__corner:max_ff_n40C_1v95 | 232
timing__unannotated_net_filtered__count__corner:max_ff_n40C_1v95 | 0
timing__unannotated_net__count | 232
timing__unannotated_net_filtered__count | 0
design_powergrid__voltage__worst__net:VPWR__corner:nom_tt_025C_1v80 | 1.79921
design_powergrid__drop__average__net:VPWR__corner:nom_tt_025C_1v80 | 1.79989
design_powergrid__drop__worst__net:VPWR__corner:nom_tt_025C_1v80 | 0.000794702
design_powergrid__voltage__worst__net:VGND__corner:nom_tt_025C_1v80 | 0.000894915
design_powergrid__drop__average__net:VGND__corner:nom_tt_025C_1v80 | 0.000109294
design_powergrid__drop__worst__net:VGND__corner:nom_tt_025C_1v80 | 0.000894915
design_powergrid__voltage__worst | 0.000894915
design_powergrid__voltage__worst__net:VPWR | 1.79921
design_powergrid__drop__worst | 0.000894915
design_powergrid__drop__worst__net:VPWR | 0.000794702
design_powergrid__voltage__worst__net:VGND | 0.000894915
design_powergrid__drop__worst__net:VGND | 0.000894915
ir__voltage__worst | 1.8000000000000000444089209850062616169452667236328125
ir__drop__avg | 0.000111000000000000001118029280267052172348485328257083892822265625
ir__drop__worst | 0.000795000000000000025222879340702775152749381959438323974609375
design__xor_difference__count | 0
magic__drc_error__count | 0
klayout__drc_error__count | 0
magic__illegal_overlap__count | 0
design__lvs_device_difference__count | 0
design__lvs_net_difference__count | 0
design__lvs_property_fail__count | 0
design__lvs_error__count | 0
design__lvs_unmatched_device__count | 0
design__lvs_unmatched_net__count | 0
design__lvs_unmatched_pin__count | 0
