ydss0857/stream-conv-engine-rtl-to-gds/asic/results/w512_80mhz/conv_engine.png

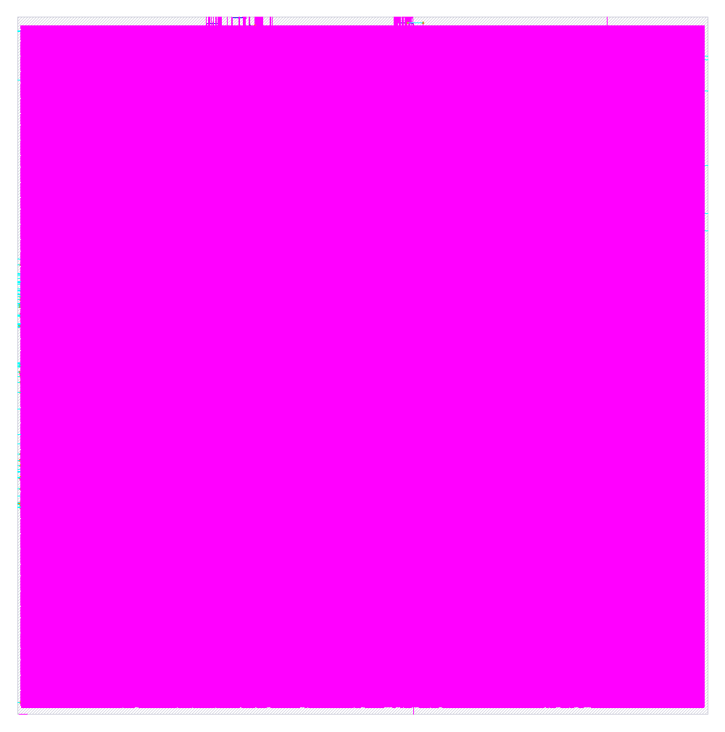
asic/results/w512_80mhz/conv_engine.png
