ydss0857/stream-conv-engine-rtl-to-gds/(commit log)

2026-10-17 grayscale_axis: fix AXI-Stream backpressure, use RBG channel order
    [grayscale_axis.v]
2026-10-17 Formal: conv_window unbounded protocol/framing proof (ABC PDR) and bounded window-contents proof (24 cycles, 3x2 frames)
2026-10-17 Coverage: Verilator flow and per-module report with waivers; close gaps (invalid config, mid-frame SOF, unaligned AXI-Lite, extreme frame shapes, readback, 720p stress) -> 100% line/branch/expr/toggle
2026-10-18 Phase 5 start: LibreLane sky130 config and run script; first run (clean DRC/LVS, timing fails at ss corner); internal skid buffers to localise stall-enable fanout
    [metrics.csv]
2026-10-18 ASIC run v2 (internal skids): ss TNS halved, WNS -2.31 ns; root cause is clkdlybuf4s25 delay cells used as fanout/input buffers; exclude them for v3; add compare.py
    [metrics.csv]
2026-10-18 ASIC run v3 (no clkdlybuf as buffers): tt Fmax 149 MHz, ss TNS -451 ns; v4 config: 80 MHz requirement-based target, larger repair slew/cap margins, wire-length buffering
    [metrics.csv]
2026-10-18 ASIC v4b (80 MHz): ss setup -1.58 ns, hold -0.20 ns (input ports only); v5: precomputed counter flags in conv_window (removes ~20-level compare path), custom SDC with realistic min input delay; fix a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
    [metrics.csv]
2026-10-18 ASIC v5: hold closed at all corners (realistic min input delay), ss setup now limited by datapath stall-enable fanout (~650 flops); conv_datapath -> free-running pipeline with credit-based output FIF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
    [metrics.csv]
2026-10-19 ASIC v6 (credit datapath): ss setup -2.32 ns / TNS -45 ns, hold clean, flow exit 0; root cause of persistent ss slew: PnR repair uses the tt corner only. v7: PNR_CORNERS=ss, FP_CORE_UTIL 50
    [metrics.csv]
2026-10-19 ASIC v7 (PnR at ss corner, 50% density): baseline. 0 DRC/LVS, hold clean all corners, passes LibreLane sky130 sign-off (tt setup); ss setup -2.27 ns / TNS -19 ns (Fmax ~68 MHz), die 0.468 mm^2
    [metrics.csv]
2026-10-19 PPA: MAX_WIDTH 64 and 256 runs (area ~165k + 926 um^2/pixel, power ~15 + 0.11 mW/pixel)
    [metrics.csv]
2026-10-19 PPA: sky130_fd_sc_hs run (ss Fmax 75 MHz, +33% area, 2.2x power); draft docs/asic.md (timing closure, width sweep, SRAM estimate, FPGA vs ASIC)
    [metrics.csv]
2026-10-19 Phase 5 complete: w512 run, four-point width fit, README ASIC section, updated FPGA numbers in docs
    [metrics.csv]
